agustinavelino/dash-40yd/docs/DASH_Documento_Maestro_v2.3.docx

# DASH TIMING SYSTEM

Sistema de cronometraje electrónico para dash de 40 yardas

DOCUMENTO MAESTRO DE ARQUITECTURA

Versión 2.3 · Reemplaza toda la documentación anterior

Campo | Detalle
Proyecto | DASH Timing System (nombre interno: Yellow-Dhaka)
Versión del documento | 2.3 — incorpora las corridas largas del VL53L1X en régimen sin retorno (fondo de vidrio, 24-oct-2026; cielo abierto, 26-oct-2026) y el ADR-013 (módulo ESP32 soldado y placa ensamblada por el fabricante). Sustituye v2.2, v2.1, v2.0, v1.0 y documentos de arquitectura previos.
Fecha de revisión | 26 de octubre de 2026
Tipo | Documento maestro de arquitectura, requisitos y plan de validación
Equipo | 1 desarrollador (servicio social / proyecto de portafolio)
Estado | Diseño congelado. Experimentos 0 y 0b completados; cadencia del sensor caracterizada (incluido el régimen sin retorno); esquemático de la PCB en curso. Pendiente compra de BOM.
Configuración | 4 puertas fijas (0 / 10 / 20 / 40 yd), reposicionables
Presupuesto estimado | $3,795 MXN (componentes + fabricación + logística). El costo de la placa ensamblada (ADR-013) está pendiente de cotización.

# 0. Sobre este documento

Este documento es la única fuente de verdad del proyecto DASH Timing System. Reemplaza en su totalidad a los siguientes documentos, que quedan marcados como obsoletos y deben archivarse en docs/history/ sin borrarse:

- dash_arquitectura_1.docx — SUPERSEDED
- dash_techstack.docx — SUPERSEDED
- DASH_Investigacion_Plan_Implementacion.docx (v1.0) — SUPERSEDED
- DASH_Documento_Maestro_v2.docx (v2.0), DASH_Documento_Maestro_v2.1.docx (v2.1) y DASH_Documento_Maestro_v2.2.docx (v2.2) — SUPERSEDED por esta versión 2.3

Esos documentos se conservan porque contienen el registro de decisiones que fueron evaluadas y descartadas. Ese historial es evidencia de criterio de ingeniería y es material valioso para el portafolio; lo que no debe ocurrir es que se sigan usando como especificación activa.

## 0.1 Qué cambió respecto a las versiones anteriores

Tema | Versión anterior | Versión 2.0
Puertas de medición | 3 puertas + receptor separado; split móvil | 4 puertas fijas (0/10/20/40 yd); la meta actúa como hub
Origen del timestamp | Central: el receptor marca la hora de llegada | Distribuido: cada nodo marca su propia hora + resync periódico
Puerta de inicio | No especificada | Disparo por levantamiento de mano (estándar NFL Combine)
Altura de montaje | No especificada | Altura de cadera (~1.0 m), inclinado 15–25° hacia arriba
Interfaz de usuario | App de escritorio Windows (Tkinter) | Página web servida por el propio ESP32 en modo SoftAP
Servidor en campo | Orange Pi Zero 2W / laptop | Ninguno. Cero infraestructura.
Nube | Fuera de alcance | Capa opcional de análisis e histórico (store & forward)
Identificación de atleta | RFID (v1.0: descartado) | Selección manual desde la página web
Requisito de precisión | ≤ 0.1 s (sin justificación) | Repetibilidad ≤ 0.05 s (1σ), con presupuesto de error por subsistema

## 0.2 Qué cambió en la versión 2.1

La versión 2.1 incorpora los resultados del smoke test y del barrido de configuración ejecutados el 11 de octubre de 2026 sobre un módulo TOF400C-VL53L1X en protoboard con un ESP32-WROOM-32U. Los números que antes venían de la hoja de datos ahora están medidos, y en un caso se corrige un concepto que estaba mal entendido (sección 9.2).

Estado de la evidencia. No todo tiene el mismo respaldo. Se marca explícitamente porque el principio rector del documento exige que cada decisión tenga un número o un criterio de prueba detrás:

Hallazgo | Respaldo | Firmeza
El periodo de INT es IMP × 0.931 | 3 puntos independientes, cociente idéntico a 4 cifras | Firme
Dos regímenes: 18.6 ms sin blanco, 37.24 ms con blanco | ~1450 muestras en dos corridas | Firme
Jitter de cadencia del chip = 10.6 µs | 51 muestras limpias, sin rescates intermedios | Firme
Alcance útil en modo corto ≈ 1.38 m | 4 transiciones observadas, consistentes | Firme
Asimetría entre regímenes: 13.7 % de intervalos anómalos sin retorno, 0 % con retorno | 648 muestras del smoke test, separadas por régimen, a IMP = 20 ms | Firme a IMP = 20 ms; sin caracterizar a 25 ms
IMP = 25 ms como configuración elegida | 51 muestras, cero saltos, todas con blanco válido | Provisional
I2C a 100 kHz; 400 kHz no aguanta | 1 observación en protoboard | Provisional

Los dos hallazgos provisionales llevan una nota explícita en el texto correspondiente. El de IMP necesita una corrida larga, apuntando al cielo con cruces intermitentes, para confirmar que el margen de 3.3 ms no se agota y que el régimen sin retorno se comporta bien a IMP = 25 ms. El de I2C se midió en protoboard con jumpers largos; sobre la PCB, con trazas cortas y pull-ups controlados, 400 kHz probablemente sí funcione y habrá que volver a medirlo.

Cambios por sección:

Sección | Cambio
1.1 | Estado actual: Experimento 0 aprobado y smoke test del sensor completado.
6 | Cuantización del muestreo recalculada con la ranura real medida: ±6.7 ms como piso, ~7.5 ms esperado con la asimetría entre regímenes (antes ±10 ms supuestos sobre una ventana de 20 ms).
9.2 | Reescrita. El timing budget y el inter-measurement period (IMP) son parámetros distintos; el techo temporal real es de 23.28 ms y sí es negociable. Asimetría entre régimen válido e inválido y su efecto sobre la cuantización.
9.3 | Alcance útil medido de 1.38 m; comportamiento ante fondo lejano y fondo traslúcido; muestras por cruce recalculadas con la ranura real.
9.4 | Comportamiento eléctrico del pin INT: activo en bajo y latcheado. Reglas obligatorias para registrar la ISR.
9.5 | Corrección de media ventana de 11.6 ms (antes 10 ms); interpolación del flanco marcada como no verificada; lockout expresado en ranuras de medición.
12.1, 12.2 | XSHUT pasa a ser obligatorio y se agrega a los test points; secuencia de reset por hardware; I2C a 100 kHz (provisional).
16.2 | Predicción del Experimento 1: 9.5 ms con ventanas uniformes, 10.7 ms con la tasa de intervalos anómalos medida; condiciones de montaje; emparejamiento de eventos por proximidad temporal.
18 | Nuevo ADR-011: inter-measurement period de 25 ms.
19 | Tres pasos nuevos antes del Experimento 1; la corrida larga de IMP se hace apuntando al cielo, no con blanco fijo.

Qué no cambia: ninguna decisión de arquitectura. El timestamp distribuido, el modo corto, el montaje a altura de cadera, la interrupción por hardware y el disparo por levantamiento de mano siguen igual de bien justificados que antes.

## 0.3 Qué cambió en la versión 2.2

La versión 2.2 incorpora dos mediciones: el barrido de configuración del VL53L1X en arranque en frío (barrido v5, 23-oct-2026) y el Experimento 0b, que midió la sincronización con el hub sirviendo la página web a varios teléfonos (23 y 24-oct-2026). Los reportes completos están en experimentos/sensor_vl53l1x/sensor_vl53l1x_resultados.md y experimentos/exp0b/experimento0b_resultados.md.

Estado de la evidencia. La tabla de 0.2 se conserva como registro de la versión 2.1. Lo nuevo, con su firmeza:

Hallazgo | Respaldo | Firmeza
Jitter de cadencia del chip: 48–315 µs según la corrida (el 10.6 µs de v2.1 no se reprodujo) | Barrido v5: 48–266 µs entre configuraciones (235 µs a IMP 25) y 44–315 µs en la misma configuración entre arranques | Varía entre corridas; siempre ≤ 1.4 % de la ranura
IMP = 25 ms entrega 1 ranura (23.31 ms) también en arranque en frío | Barrido v5: 119 intervalos, 0 anómalos; periodo = ⌈T / ranura⌉ × ranura en 11 configuraciones (desviación ≤ 0.009 ranuras) | Firme en régimen válido; régimen inválido pendiente
Margen real a IMP = 25 ms: 0.94–2.8 ms, no 3.3 ms | Barrido v5 acota la duración real de la medición a 20.48 < T ≤ 22.34 ms | Firme
Sincronización con el hub sirviendo la página: σ ≤ 488 µs | Experimento 0b: 6 corridas de 200 pulsos, 0 eventos perdidos | Firme
La carga del SoftAP sube las ráfagas de resync lentas de 14 % a 30 % | 100 ráfagas por condición; Fisher p = 0.010 | Firme en banco; sin medir en campo
Brownout del hub con SoftAP cargado y alimentación USB | 1 episodio de 422 reinicios y 1 reinicio aislado al abrir el puerto | Provisional: causa física sin aislar

Cambios por sección:

Sección | Cambio
1.1 | Estado actual: barrido del sensor en arranque en frío completado y Experimento 0b ejecutado.
6 | Sincronización entre nodos: se agrega el valor medido con el hub sirviendo la página (σ ≤ 0.49 ms por corrida).
9.2 | Margen de 0.94–2.8 ms en lugar de 3.3 ms; jitter de cadencia variable entre corridas; modelo de ranuras enteras; ADR-011 confirmado en arranque en frío.
11.2 | Evidencia de brownout del hub bajo carga del SoftAP.
13.2 | El aislamiento de núcleos deja de ser necesario para cumplir REQ-NF-02 y pasa a opción.
16.2 | Nueva: Experimento 0b. Los Experimentos 1–4 pasan a 16.3–16.6.
16.3 | Evidencia previa del Experimento 1 actualizada con el jitter de cadencia del barrido v5.
17 | Dos riesgos nuevos: brownout del hub y degradación del resync por la carga del SoftAP.
18 | ADR-011 con el margen real; ADR candidato de reintento de ráfagas lentas, pendiente de decisión.
19 | Pasos completados resumidos; pasos nuevos: decisión sobre el reintento de ráfagas y medición del riel de 3.3 V del hub.

Qué no cambia: ninguna decisión de arquitectura. El Experimento 0b confirma que el nodo de 40 yd puede ser meta y hub a la vez (ADR-002, ADR-009): no hace falta un quinto ESP32 dedicado al SoftAP.

## 0.4 Qué cambió en la versión 2.3

La versión 2.3 incorpora dos corridas largas del VL53L1X a IMP = 25 ms en régimen sin retorno, con cruces guiados por un LED: fondo de vidrio fuera de alcance (24-oct-2026) y cielo abierto (26-oct-2026). Además registra el ADR-013, que cambia la placa de producto. El reporte del sensor está en experimentos/sensor_vl53l1x/sensor_vl53l1x_resultados.md (secciones 11 y 12) y el ADR en docs/adr/ADR-013-modulo-soldado-pcba.md.

Estado de la evidencia. Las tablas de 0.2 y 0.3 se conservan como registro. Lo nuevo, con su firmeza:

Hallazgo | Respaldo | Firmeza
IMP = 25 ms no salta a 2 ranuras (46.6 ms) con blanco | 0 de 2 076 intervalos con blanco en dos corridas largas (vidrio 0/1 054, cielo 0/1 022) | Firme
Sin blanco, 3.0–3.3 % de intervalos anómalos a IMP = 25 ms (13.7 % a IMP = 20 ms) | 3 918 intervalos al cielo y 3 878 con vidrio; fondo verificado: 0 y 1 muestras válidas con el LED apagado hace más de 1 s | Firme
Dos fases del INT: sin blanco va ~9.5–9.9 ms adelantado; la primera detección de cada cruce cae en la fase con blanco | 29 de 29 cruces al cielo y 30 de 31 con vidrio; los anómalos sin blanco son una sola interrupción tardía (51 de 60 pares + −) | Firme como observación; el mecanismo (medición abortada sin retorno) no está verificado
Efecto del cambio de fase en el error del cruce | Escenario: si la ventana de la detección es el intervalo completo (~33.2 ms), σ ≈ 9.6 ms por sensor | Sin medir: lo mide el Experimento 1
Módulo ESP32 soldado y placa ensamblada por el fabricante (ADR-013) | Decisión de diseño; resuelve las dos fuentes en el riel de 3.3 V y los footprints de módulos genéricos | Decisión; costo pendiente de cotización

Cambios por sección:

Sección | Cambio
Portada y 0 | Versión 2.3 y esta sección.
1.1 | Estado actual: cadencia del sensor caracterizada, esquemático de la PCB en curso (ADR-013), prototipo de la página web.
9.2 | Corridas largas a IMP = 25 ms en régimen sin retorno; la nota provisional se cierra; hallazgo de las dos fases del INT.
9.3 | El cielo abierto se confirma como fondo sin retorno.
9.5 | La corrección de media ventana queda sujeta al cambio de fase en el cruce.
12.1, 12.2, 12.5 | ADR-013: módulo WROOM-32UE soldado, cargador y buck-boost con integrados, un solo USB-C con CH340C, ensamblado por el fabricante.
15.1, 15.2 | Notas del ADR-013; el costo de fabricación con ensamblado queda pendiente de cotización.
16.3 | El Experimento 1 debe registrar el intervalo previo a cada detección. La predicción escrita no cambia.
17 | Riesgos de la PCB y de los módulos genéricos actualizados por el ADR-013.
18 | ADR-011 confirmado en régimen sin retorno; ADR-013 nuevo.
19 | Corrida larga del sensor completada; pasos nuevos: cotización de la placa ensamblada y embeber la página.

Qué no cambia: IMP = 25 ms (ADR-011) se mantiene, y ninguna decisión de arquitectura de tiempo, comunicación o software cambia. El ADR-013 cambia solo la placa de producto: los experimentos siguen sobre tarjetas de desarrollo.

Principio rector del documento

Toda decisión técnica aquí registrada tiene una justificación numérica o un criterio de prueba asociado. Si una decisión no puede defenderse con un número o con un experimento, es una preferencia, no una decisión de ingeniería, y debe marcarse como tal.

# 1. Resumen ejecutivo

DASH Timing System es un sistema portátil de cronometraje electrónico de bajo costo para medir el dash de 40 yardas y sus tiempos de split intermedios, dirigido a una liga juvenil de futbol americano en la Ciudad de México.

El sistema está compuesto por cuatro dispositivos físicos idénticos, construidos sobre un único diseño de PCB, cuyo rol se define por configuración mediante jumpers. Cada dispositivo integra una tarjeta ESP32-WROOM-32UE con antena externa, un sensor de distancia por Tiempo de Vuelo (ToF) VL53L1X y un subsistema de energía basado en celda Li-ion 18650.

Los cuatro dispositivos se colocan a lo largo de un carril lineal en las marcas de 0, 10, 20 y 40 yardas, replicando el protocolo del NFL Combine. Cada nodo detecta el cruce del atleta mediante interrupción por hardware del sensor y marca el instante con su propio reloj local. Los relojes se mantienen alineados mediante un protocolo de resincronización periódica por ESP-NOW, de modo que la latencia variable del enlace inalámbrico no contamina la medición.

El nodo de meta cumple además el rol de concentrador: agrega los timestamps de las cuatro puertas, calcula los splits y levanta un punto de acceso WiFi propio (SoftAP) que sirve una página web ligera. El coach se conecta desde su teléfono y ve los resultados en menos de dos segundos, sin necesidad de laptop, router, internet ni ningún equipo adicional en el campo.

De forma opcional y no crítica, cuando exista conectividad a internet el sistema sincroniza el histórico hacia un backend en la nube donde reside el análisis pesado: perfiles de velocidad, comparativas entre atletas, progreso longitudinal y ajuste del modelo biomecánico de sprint.

## 1.1 Estado actual

Elemento | Estado
Arquitectura y requisitos | Congelados en este documento
Componentes | Kit de arranque en uso (ESP32-WROOM-32U en protoboard, módulo TOF400C-VL53L1X). Resto del BOM pendiente de compra.
Validación de sincronización inalámbrica | Completada — Experimento 0 aprobado: σ = 168 µs, margen de 30× sobre REQ-NF-02. Experimento 0b (hub con SoftAP y carga web): σ ≤ 488 µs, margen de 10× (sección 16.2).
Caracterización del sensor ToF | Cadencia completada — smoke test y barridos (11 y 23-oct-2026) y corridas largas en régimen sin retorno con vidrio y al cielo abierto (24 y 26-oct-2026), sección 9.2. Pendientes: Experimento 1 y pruebas solares.
Diseño de PCB | Esquemático en curso: módulo WROOM-32UE soldado y placa ensamblada por el fabricante (ADR-013), con las adiciones de la sección 12.
Firmware | Firmware de experimentos sobre protoboard (Experimentos 0 y 0b, smoke test y barridos del sensor). Firmware de producto no iniciado.
Página web local | Prototipo hecho con hub simulado (24-oct-2026), 8.7 KB con gzip, contrato hub ↔ página en webapp/PROTOCOLO.md. Falta embeberla en el hub. El Experimento 0b confirmó que el hub puede servir una página de 237 KB comprimida a 3 teléfonos sin salir de REQ-NF-02.
Backend en nube | No iniciado — fase posterior, no bloqueante

# 2. Planteamiento del problema

Los programas de futbol americano juvenil miden el dash de 40 yardas con cronómetros manuales operados por entrenadores, quienes además aproximan los splits intermedios a ojo. Esta práctica introduce tres problemas medibles:

- Error de reacción humana: el operador arranca y detiene el cronómetro con un retardo de reacción de 150–300 ms, sesgado sistemáticamente hacia tiempos más rápidos.
- Falta de repetibilidad: dos operadores distintos, o el mismo operador en dos ocasiones, producen tiempos que difieren lo suficiente como para enmascarar el progreso real del atleta.
- Ausencia de splits confiables: sin tiempos intermedios no es posible distinguir un atleta con buena aceleración de uno con buena velocidad máxima, que es precisamente la información que cambia el plan de entrenamiento.

DASH resuelve esto con un sistema electrónico portátil que mide automáticamente el tiempo total y los splits, con repetibilidad de nivel entrenamiento, instalable y operable en minutos por usuarios sin conocimientos técnicos, en condiciones reales de campo.

Advertencia operativa que debe comunicarse al coach antes de la primera sesión

Los tiempos cronometrados a mano son sistemáticamente más rápidos que los electrónicos, típicamente por 0.20–0.30 s, debido al retardo de reacción del operador. Los tiempos de los atletas parecerán empeorar el día que se instale el sistema. Si esta conversación no se tiene por adelantado, el sistema será percibido como descalibrado. Documentar el sesgo y explicarlo es parte del entregable, no un detalle accesorio.

# 3. Objetivos

- Medir el dash de 40 yardas con splits en 10 y 20 yardas, replicando el protocolo del NFL Combine, en una sola corrida del atleta.
- Alcanzar repetibilidad de 0.05 s (1σ) o mejor en corridas repetidas del mismo atleta bajo condiciones equivalentes.
- Entregar retroalimentación visible al coach y al atleta en menos de 2 segundos tras cruzar la meta, sin requerir laptop, router, internet ni infraestructura de red en el campo.
- Permitir instalación y puesta en marcha completa en 10 minutos o menos por un usuario sin conocimientos técnicos.
- Operar de forma confiable a la intemperie bajo condiciones típicas de la Ciudad de México, incluyendo sol directo y lluvia ligera.
- Mantener una plataforma de hardware estandarizada: un único diseño de PCB replicado en los cuatro dispositivos, con el rol definido por configuración.
- Garantizar cero pérdida de datos ante fallas de conectividad, mediante almacenamiento local y sincronización diferida.
- Habilitar análisis de desempeño más allá de los tiempos crudos: velocidades por tramo, curva de aceleración y ajuste del modelo biomecánico de sprint.
- Garantizar reproducibilidad total del proyecto: diseño de PCB, firmware, software, documentación de ensamble y procedimientos de calibración publicados.
- Demostrar competencia de ingeniería de nivel profesional en firmware embebido, sistemas inalámbricos de sensado, diseño de PCB, integración hardware-software y validación experimental.

# 4. Alcance y no-objetivos

La Versión 1 comprende un sistema de cronometraje de carril único para medir desempeño en línea recta. Cuatro estaciones sensoras se colocan a lo largo de una pista lineal, se comunican de forma local e inalámbrica, y presentan resultados en una página web servida por el propio sistema.

El diseño contempla operación en interiores y exteriores, con las estaciones montadas en tripié sobre terreno razonablemente nivelado, tolerando exposición solar y lluvia ligera. Toda la comunicación ocurre en una red inalámbrica local; la conectividad a internet es estrictamente opcional y nunca está en la ruta de medición.

## 4.1 No-objetivos explícitos

- Cronometraje multi-carril o de múltiples atletas simultáneos.
- Identificación automática del atleta (RFID, NFC, visión). La selección es manual desde la interfaz web.
- Aplicación móvil nativa. La interfaz es una página web abierta en el navegador del teléfono.
- Aplicación de escritorio. Eliminada respecto a v1.0.
- Dependencia de conectividad a internet para la operación de medición.
- Analítica basada en IA o interpretación automática del desempeño.
- Precisión certificada de competencia profesional.

# 5. Requisitos y criterios de éxito

Los requisitos de la versión 1.0 se revisan aquí. En particular, el requisito anterior de precisión (≤ 0.1 s) se reemplaza porque era demasiado laxo: el sistema lo cumple sin esfuerzo de diseño, y un requisito que se satisface solo no sirve para guiar decisiones ni para detectar regresiones.

## 5.1 Requisitos funcionales

ID | Requisito | Criterio de prueba
REQ-F-01 | Detectar el cruce del atleta en las cuatro puertas | Pruebas controladas de caminata y carrera activan las 4 puertas en el orden esperado
REQ-F-02 | Iniciar el cronometraje por levantamiento de mano en modo armado | El cronómetro arranca sin intervención humana al despejarse la puerta de inicio
REQ-F-03 | Registrar splits de 10, 20 y 40 yardas en una sola corrida | Los tiempos registrados corresponden a la secuencia esperada y son monótonos crecientes
REQ-F-04 | Asociar cada corrida con un atleta del roster | El coach selecciona el atleta en la página web y el CSV refleja la asociación
REQ-F-05 | Mostrar resultados en el teléfono del coach | Resultados visibles en ≤ 2 s tras el cruce de meta
REQ-F-06 | Registrar la distancia real de cada puerta con cada corrida | El CSV incluye las distancias configuradas; al mover una puerta y actualizar el parámetro, el cambio se refleja
REQ-F-07 | Exportar los datos a CSV | Archivo descargable desde la página web y legible en hoja de cálculo
REQ-F-08 | Permitir promover cualquier nodo al rol de hub | Cambiando los jumpers, un nodo sensor asume el rol de concentrador y el sistema opera en modo degradado

## 5.2 Requisitos no funcionales

ID | Requisito | Criterio de prueba
REQ-NF-01 | Repetibilidad de medición ≤ 0.05 s (1σ) | Análisis estadístico de 10 corridas repetidas del mismo atleta
REQ-NF-02 | Jitter de la infraestructura de tiempo ≤ 5 ms (1σ) | Experimento 0: histograma de 200 disparos con evento común cableado
REQ-NF-03 | Tasa de detección ≥ 99 % con el atleta dentro del carril marcado | 200 pasadas; se contabilizan las no detectadas
REQ-NF-04 | Instalación completa en ≤ 10 minutos | Un usuario nuevo completa el despliegue cronometrado
REQ-NF-05 | Autonomía mínima de 1 hora continua en modo armado | Prueba de descarga bajo ciclo de trabajo real de sensado y radio
REQ-NF-06 | Operación bajo sol directo y lluvia ligera | Operación exitosa en campo a mediodía y bajo aspersión controlada
REQ-NF-07 | Cero pérdida de datos ante caída de conectividad | Se desconecta la red durante una sesión; al restablecerse, todos los resultados están presentes
REQ-NF-08 | La página web opera sin acceso a internet | El teléfono conectado al SoftAP, sin datos móviles, carga la página completa

# 6. Presupuesto de error

Esta sección es la base cuantitativa de todas las decisiones de diseño del documento. Ninguna elección de componente o arquitectura debe tomarse sin referirse a ella.

El error total del sistema se descompone en contribuciones independientes que se combinan en raíz de la suma de cuadrados (RSS), porque son fuentes aleatorias no correlacionadas entre sí.

Fuente de error | Magnitud (1σ) | Naturaleza y tratamiento
Geometría corporal | ±20–50 ms | DOMINANTE. Qué parte del cuerpo cruza primero varía con la fase de zancada. Se mitiga con altura de montaje, no se elimina.
Cuantización del muestreo | ±6.7 ms (MEDIDO) | Ranura real de 23.28 ms (IMP 25 ms). σ = ventana / √12 = 6.72 ms. Dentro del presupuesto de ±10 ms. Valor de piso: supone ventanas uniformes. Con la tasa de intervalos anómalos medida en régimen inválido, el valor esperado sube a ~7.5 ms (sección 9.2).
Sincronización entre nodos | ±0.17 ms (MEDIDO); ≤ 0.49 ms con carga web (MEDIDO) | Resync ping-pong cada 30 s con filtro de latencia mínima sobre ráfaga de 7. Verificado por el Experimento 0: σ = 168 µs, 30× mejor que REQ-NF-02. Con el hub sirviendo la página a 3 teléfonos (Experimento 0b, 16.2): σ ≤ 488 µs por corrida, error del offset σ 217 µs y máximo 935 µs sobre 100 ráfagas; 10× mejor que REQ-NF-02.
Deriva de cristal | ±1 ms | 35 ppm relativos entre dos cristales = 35 µs/s. Con resync a 30 s no alcanza a acumularse.
Latencia de ISR y firmware | < 0.1 ms | Despreciable si el timestamp se captura como primera instrucción de la ISR.
Latencia del enlace de radio | 0 ms | ELIMINADA por diseño: el timestamp nace en el nodo, no en el receptor.

Error total por puerta: la contribución de sincronización resultó un orden de magnitud menor que lo presupuestado, por lo que el error total queda aún más dominado por la geometría corporal de lo que se estimaba originalmente. Esto refuerza la conclusión de 6.1: invertir en resolución temporal no produce mejora significativa.

La cuantización del sensor se determinó a partir del periodo real de muestreo medido (sección 9.2) y resultó de 6.7 ms (1σ), dentro del presupuesto estimado. Sumada en cuadratura con la geometría corporal, el error total por puerta queda prácticamente sin cambio respecto a la estimación original, porque la geometría sigue dominando por un factor de 3 a 7.

## 6.1 Consecuencias de diseño

- El sistema distingue confiablemente un 5.10 de un 5.20. No distingue un 5.10 de un 5.12. Los tiempos se reportan a centésimas, acompañados de la incertidumbre documentada.
- La geometría corporal domina el presupuesto. Por lo tanto, invertir en un sensor con mayor resolución temporal produciría una mejora marginal (del orden del 5 %) a costo y complejidad significativos. El VL53L1X es la elección correcta precisamente porque su error es del mismo orden que el error irreducible.
- Un enlace cableado eliminaría el error de sincronización (~1–2 ms), lo que representa aproximadamente el 3 % del error total, a cambio de tender 80 m de cable en un campo donde hay atletas esprintando. La relación costo-beneficio es desfavorable y viola REQ-NF-04. Ver ADR-007.
- Buena parte del error de geometría corporal es sistemático para un mismo atleta en un mismo día, por lo que las comparaciones relativas (progreso, ranking) son más confiables que los valores absolutos. Este es el uso principal que le dará el coach.

# 7. Arquitectura del sistema

## 7.1 Topología física

Cuatro dispositivos idénticos, montados en tripié al costado del carril de carrera, en las marcas de 0, 10, 20 y 40 yardas. La configuración por defecto replica el protocolo del NFL Combine, pero al ser inalámbricos los nodos pueden reposicionarse libremente; la distancia real de cada puerta es un parámetro configurable en la interfaz (REQ-F-06).

Puerta | Rol de firmware | Función
0 yd | Nodo de inicio | Sensor apuntando hacia abajo a la mano de apoyo del atleta. Dispara por flanco de subida (la mano se levanta).
10 yd | Nodo de split | Sensor apuntando al carril. Dispara por flanco de bajada (cuerpo entra al haz).
20 yd | Nodo de split | Idéntico al de 10 yd.
40 yd | Nodo de meta + hub | Detecta la meta, agrega los timestamps de las cuatro puertas, calcula splits, levanta SoftAP y sirve la página web.

## 7.2 Flujo de una corrida

1. El coach abre la página web del sistema desde su teléfono, selecciona al atleta y arma el sistema.
2. El atleta se coloca en posición de tres puntos, con la mano de apoyo bajo el sensor de la puerta de 0 yd.
3. El atleta arranca. Al levantar la mano, el nodo de inicio detecta el flanco de subida y captura T0 con su reloj local.
4. El atleta cruza 10, 20 y 40 yardas. Cada nodo captura su timestamp local mediante interrupción por hardware.
5. Cada nodo transmite su evento al hub por ESP-NOW. El instante de llegada del paquete es irrelevante para la medición.
6. El hub aplica los offsets de reloj conocidos, calcula los splits y el tiempo total, y almacena el resultado localmente.
7. La página web del coach se actualiza y muestra el resultado en menos de 2 segundos.
8. Si hay conectividad a internet disponible, el hub sincroniza el resultado al backend en la nube. Si no la hay, el dato permanece en el buffer local hasta que la haya.

## 7.3 Interfaces entre subsistemas

Interfaz | Tipo | Datos / Señal | Responsable
Sensor → MCU (datos) | I2C | Valor de distancia | Nodo sensor
Sensor → MCU (evento) | GPIO / interrupción | Flanco de detección | Hardware + firmware
Nodo → Hub | ESP-NOW | Paquete con timestamp local y traza de muestras | Firmware
Hub ↔ Nodos | ESP-NOW | Protocolo de resincronización de reloj | Firmware
Hub → Coach | WiFi SoftAP / HTTP | Página web y resultados en vivo | Firmware + web
Hub → Nube | WiFi cliente / HTTPS | Sincronización diferida de histórico | Firmware + backend
Energía → Nodo | 3.3 V DC | Riel regulado | Subsistema de energía

# 8. Geometría de montaje y semántica de disparo

## 8.1 Altura de montaje

Un sensor de puerta no detecta un atleta: detecta el primer objeto sólido que entra en su haz. El cuerpo de un corredor no cruza la línea como un bloque; las extremidades se despliegan por delante del torso y oscilan según la fase de zancada.

Punto del cuerpo | Adelanto típico | Consecuencia
Mano en swing | ~45 cm | Adelanta el disparo ~50 ms y varía corrida a corrida
Pie en extensión | ~50 cm | Adelanta el disparo ~55 ms y varía con la cadencia
Cadera | referencia | Punto de mínima varianza; proxy del centro de masa

Decisión: montar el plano de detección a la altura de la cadera del atleta, en el rango de 0.9 a 1.1 m según el roster real. La cadera se mueve a velocidad casi constante mientras las extremidades oscilan alrededor de ella, por lo que es el punto que minimiza la varianza entre corridas.

Una vez fijada, la altura de montaje se documenta como parámetro de calibración y no se modifica entre sesiones; cambiarla invalida las comparaciones históricas.

## 8.2 Inclinación del sensor

El sensor se monta bajo (aproximadamente 0.5–0.6 m) e inclinado 15–25° hacia arriba, apuntando a la altura de cadera del atleta. Esta geometría responde a dos razones independientes que apuntan en la misma dirección:

- Mecánica: el trípode queda con centro de gravedad bajo, es más estable frente al viento, y sus patas quedan más lejos de la trayectoria del atleta.
- Óptica: al apuntar hacia arriba, el fondo del haz es cielo abierto, es decir, ausencia de retorno. Esto convierte la detección en un evento binario limpio (sin retorno → retorno válido a ~1 m) en lugar de una detección diferencial contra un fondo variable como pasto, barda o público.

## 8.3 Semántica de disparo: por qué la puerta de inicio es distinta

Para las puertas de 10, 20 y 40 yardas la lógica es directa: se dispara por flanco de bajada, es decir, cuando la distancia medida cae abruptamente porque un cuerpo entró al haz.

La puerta de inicio no puede usar esa lógica. En un dash de 40 yardas el atleta arranca detenido, en posición de tres puntos, con la mano apoyada sobre la línea de salida. Si la puerta de inicio dispara por bloqueo, el cronómetro arranca cuando el atleta se acomoda, no cuando arranca.

Opción | Mecanismo | Evaluación
A — Atleta detrás | El atleta se coloca ~30 cm detrás de la línea; flanco de bajada normal | Hardware idéntico, pero el brazo al extenderse dispara antes que la cadera y la distancia de retraso varía por atleta
B — Flanco de subida | El atleta se acomoda dentro del haz; arranca al despejarlo | Auto-disparo, pero el despeje ocurre cuando sale la última parte del cuerpo, no cuando arrancó
C — Levantamiento de mano | Sensor apuntando hacia abajo a la mano de apoyo; dispara al levantarse | SELECCIONADA. Es el estándar del NFL Combine y el único evento discreto y bien definido

Se selecciona la opción C. El levantamiento de la mano es un evento binario y repetible, a diferencia de un cuerpo cruzando un plano, que es intrínsecamente borroso. Reduce el error de la puerta de inicio de aproximadamente ±50 ms a ±20 ms, y el inicio es donde el error duele más porque contamina todos los splits de la corrida. No implica hardware adicional: es el mismo módulo, el mismo sensor, apuntando hacia abajo, con lógica de flanco de subida en firmware.

# 9. Sensado por Tiempo de Vuelo

## 9.1 Principio de funcionamiento

El VL53L1X emite pulsos de láser infrarrojo a 940 nm, mide el tiempo de viaje de ida y vuelta de la luz reflejada, y calcula la distancia. Dado que la luz viaja a aproximadamente 30 cm por nanosegundo, la medición interna ocurre en el orden de picosegundos y la realiza silicio dedicado (arreglo de fotodiodos SPAD más convertidor tiempo-digital). El microcontrolador nunca participa en esa medición: solo lee el resultado.

## 9.2 Timing budget e inter-measurement period: el techo temporal

Un solo pulso produce una señal demasiado débil. El chip acumula fotones de miles de pulsos para promediar el ruido; ese periodo de acumulación es el timing budget. Más budget significa mediciones más limpias y de mayor alcance, pero más lentas.

El timing budget no es, sin embargo, la cadencia con la que el sensor avisa al microcontrolador. Esa la fija un segundo parámetro independiente, el inter-measurement period (IMP), y la relación entre ambos determina el techo real del sistema. Confundirlos fue un error de la versión anterior de este documento.

Medición (smoke test, 11-oct-2026, módulo TOF400C sobre protoboard):

periodo real de INT = IMP solicitado × 0.931

El factor 0.931 es un error de escala del 6.9 % que introduce la conversión de milisegundos a cuentas del oscilador interno del sensor. Se verificó con tres valores independientes de IMP (25, 33 y 40 ms), que arrojaron cocientes de 0.9313, 0.9309 y 0.9307.

La consecuencia práctica es que la ranura temporal real debe ser mayor que el budget; de lo contrario el chip no alcanza a terminar la medición dentro de ella y se salta una ranura completa:

IMP solicitado | Ranura real | ¿Cabe un budget de 20 ms? | Periodo de INT
20 ms | 18.62 ms | No | 37.24 ms (se salta una)
25 ms | 23.28 ms | Sí | 23.28 ms
33 ms | 30.72 ms | Sí | 30.72 ms
40 ms | 37.23 ms | Sí | 37.23 ms

Esto explica un comportamiento observado en el smoke test que parecía anómalo: con IMP = 20 ms el sensor entregaba 18.6 ms cuando no había blanco y 37.24 ms cuando sí lo había. Sin blanco la medición aborta temprano y cabe en la ranura; con blanco válido usa el budget completo, no cabe, y el chip entrega cada dos ranuras.

Configuración seleccionada: IMP = 25 ms, que produce un periodo real de 23.28 ms (43 mediciones por segundo). Es la ranura más corta que acomoda una medición completa en modo corto, con un margen de entre 0.94 y 2.8 ms (ver el barrido en arranque en frío, abajo). Ver ADR-011.

Estabilidad de la cadencia: en el smoke test el jitter medido fue de 10.6 µs (1σ) sobre 51 muestras. El barrido en arranque en frío no lo reprodujo: midió 48–266 µs según la configuración (235 µs a IMP = 25 ms) y 44–315 µs en una misma configuración entre arranques. Aun el máximo es ≤ 1.4 % de la ranura: el chip mantiene su ritmo con su propio reloj, lo que confirma que la cuantización de la ventana es la única fuente significativa de error temporal del sensor.

Barrido en arranque en frío (23-oct-2026): once valores de IMP entre 10 y 25 ms, un arranque en frío por configuración, blanco fijo a 1.105 m, 120 muestras cada uno. En todos el periodo resultó un número entero de ranuras, periodo = ⌈T / ranura⌉ × ranura, con desviación ≤ 0.009 ranuras. IMP = 25 ms dio 1 ranura (23.31 ms) con 0 de 119 intervalos anómalos: ADR-011 se confirma también en arranque en frío. Como IMP = 22 ms necesita 2 ranuras (20.48 ms no alcanzan) e IMP = 12 ms cabe en 2 × 11.17 = 22.34 ms, la duración real de la medición queda acotada a 20.48 < T ≤ 22.34 ms. El margen real a IMP = 25 ms está entre 0.94 y 2.8 ms, no los 3.3 ms que resultaban de suponer T igual al budget.

Asimetría entre regímenes. La estabilidad anterior corresponde al régimen con retorno válido. El análisis separado de las 648 muestras del smoke test muestra que los dos regímenes no se comportan igual:

Régimen | Intervalos anómalos | Jitter de los limpios
Válido (con blanco) | 0 de 404 (0 %) | 81 µs
Inválido (sin retorno) | 33 de 241 (13.7 %) | 266 µs

En el régimen inválido uno de cada siete intervalos se alarga aproximadamente 9.3 ms, medio cuanto de la cadencia interna. El régimen válido no presenta un solo caso.

Esto tiene consecuencia directa sobre el presupuesto de error, porque las puertas de split y meta apuntan al cielo y permanecen en régimen inválido hasta que llega el atleta. Si las ventanas de medición no son todas del mismo ancho, el error de cuantización deja de ser uniforme y su varianza aumenta. Estimado con la tasa medida:

| Sin intervalos anómalos | Con la tasa medida
σ de cuantización por sensor | 6.72 ms | 7.54 ms (+12 %)
Predicción del Experimento 1 | 9.5 ms | 10.7 ms

El presupuesto de ±10 ms se sostiene, pero 6.72 ms debe leerse como piso, no como valor esperado.

La puerta de inicio es la excepción: apunta hacia abajo a la mano y después al suelo, por lo que siempre tiene retorno válido y opera en el régimen limpio.

Esta tasa se midió a IMP = 20 ms. A IMP = 25 ms resultó mucho menor (3.0–3.3 %, abajo).

A 9 m/s el atleta recorre 21 cm entre muestras.

Corridas largas a IMP = 25 ms en régimen sin retorno (24 y 26-oct-2026). 5 000 interrupciones por corrida en arranque en frío, con cruces de mano o cartulina a 0.3–1 m guiados por un LED que se enciende 1 s cada 4 s. El estado del LED queda en cada muestra, lo que permite verificar que el fondo no da retorno:

Corrida | Sin blanco: intervalos anómalos | Con blanco: saltos a 2 ranuras
Smoke test, IMP = 20 ms (11-oct) | 33 de 241 (13.7 %), +9.3 ms | —
Vidrio a ~2 m, IMP = 25 ms (24-oct) | 127 de 3 878 (3.3 %), ±9.5 ms | 0 de 1 054
Cielo abierto, IMP = 25 ms (26-oct) | 118 de 3 918 (3.0 %), ±9.9 ms | 0 de 1 022

El fondo no cambia la cadencia: al cielo, 0 de 2 471 muestras salieron válidas con el LED apagado hace más de 1 s (vidrio: 1 de 2 473). El chip reporta el cielo sobre todo como status 2 (signal fail) y el vidrio como status 4 (fuera de rango); la cadencia es la misma.

Dos fases del INT. Midiendo la fase de cada interrupción contra sus vecinas: sin blanco, el INT va ~9.9 ms adelantado (9.5 ms con vidrio) respecto a la fase con blanco. En los 29 cruces al cielo, la primera muestra válida llega en la fase con blanco, +10.0 ms (mediana) respecto a las muestras anteriores; con vidrio, 30 de 31. Los anómalos sin blanco son casi todos una sola interrupción que regresa un instante a la fase con blanco (un intervalo largo seguido de uno corto: 51 de 60), casi siempre con status 2. Hipótesis sin verificar: sin retorno la medición aborta antes de completar el budget y el INT sale antes.

Consecuencia para el presupuesto de error. La tabla de arriba (7.54 ms, 10.7 ms) suponía que el intervalo largo era la excepción (13.7 %). A IMP = 25 ms los anómalos sin blanco son 3 %, pero el intervalo que termina en la detección es el largo (~23.3 + 9.9 ≈ 33.2 ms) en cada cruce. Si la ventana de cuantización de la detección fuera ese intervalo completo, σ ≈ 33.2 / √12 ≈ 9.6 ms por sensor, todavía dentro de ±10 ms pero sin margen. No está medido: depende de en qué momento de la medición el chip ve el blanco. Lo resuelve el Experimento 1 (sección 16.3).

Nota (cerrada el 26-oct-2026)

La elección de IMP = 25 ms se validó con 51 muestras sin saltos, se confirmó en arranque en frío (119 intervalos, 0 anómalos) y después en régimen sin retorno con dos corridas largas, contra un vidrio y al cielo abierto. Las dos dudas de la versión 2.2 quedan resueltas:

1. El margen de 0.94–2.8 ms no se agotó: 0 saltos a 46.6 ms en 2 076 intervalos con blanco.

2. El régimen inválido a IMP = 25 ms se comporta mejor que a IMP = 20 ms: 3.0–3.3 % de intervalos anómalos contra 13.7 %, sin perder ranuras.

Los valores de IMP entre 26 y 28 ms ya no hacen falta como alternativa. Queda una pregunta nueva, que no cuestiona el IMP: cuánto error agrega el cambio de fase de ~9.9 ms en el instante del cruce. La responde el Experimento 1.

## 9.3 Modo de corta distancia

Se opera el sensor en modo de corta distancia (alcance nominal ~1.3 m). Esta decisión responde a dos motivaciones que coinciden:

- Inmunidad a luz ambiente: el sol emite fuertemente en 940 nm, la misma longitud de onda del sensor. Bajo sol directo el alcance útil se desploma. El modo corto es el más robusto frente a esta interferencia.
- Resolución temporal: el modo corto permite el timing budget más bajo, que es exactamente lo que se necesita para cronometrar.

Alcance útil medido: 1.38 m (smoke test, 11-oct-2026). El corte es abrupto y repetible: en cuatro transiciones observadas el estatus pasó de válido a fuera de rango entre 1372 y 1395 mm. Este valor, y no el nominal de hoja de datos, es el que debe usarse para fijar el ancho del carril marcado con conos.

Se observó también que un fondo lejano en modo corto se comporta como ausencia de retorno, lo que confirma la premisa de la sección 8.2. El tipo de fondo importa: una superficie traslúcida (cortina sheer a 2.3 m) produjo una mezcla inestable de estatus inválidos, porque parte de la luz la atraviesa y genera dos retornos a distancias distintas. En campo el fondo es cielo abierto, que es el mejor caso posible. Confirmado el 26-oct-2026: al cielo abierto, 0 de 2 471 muestras válidas sin blanco (sección 9.2).

Restricción operativa derivada: el atleta debe pasar a menos de 1.3 m del trípode. Se mitiga marcando el carril con conos. Los modos medio (3 m) y largo (4 m) quedan como alternativa a caracterizar en campo: si en condiciones de entrenamiento vespertino resultan confiables, otorgan margen adicional. Esta caracterización es parte del plan de validación (sección 16).

Nota sobre el campo de visión: a 27° y 80 cm el haz mide aproximadamente 38 cm. A 9 m/s el atleta recorre 21 cm entre muestras (sección 9.2), de modo que un punto del cuerpo cruzando el haz produce cerca de 2 muestras, y el torso completo, considerando su extensión longitudinal, alrededor de 3. En las puertas de 10 y 20 yardas el atleta va más lento y el número es mayor. Reducir el ROI para ganar inmunidad adicional dejaría 1 muestra y eliminaría la capacidad de validar el evento. No se debe optimizar el ROI antes de haber medido.

## 9.4 Detección por interrupción de hardware

El método por el cual el microcontrolador se entera de un evento determina directamente el jitter de la medición. Hay dos opciones y sólo una es aceptable.

Método | Mecanismo | Evaluación
Polling | El MCU consulta por I2C repetidamente si hay dato nuevo | Cada consulta ocupa el bus ~0.5 ms; el instante real del evento queda indeterminado dentro del ciclo de polling. Introduce decenas de ms de jitter.
Interrupción | El sensor baja físicamente el pin INT cuando se cumple la condición; el MCU salta a la ISR en ~2 µs | SELECCIONADA. El timestamp se captura antes de tocar el bus I2C.

La interrupción requiere las tres cosas simultáneamente:

- Hardware: una conexión física del pin INT del módulo sensor a un GPIO del ESP32. Sin este cable la interrupción no existe.
- Configuración del sensor por I2C: se programa el chip para que active INT únicamente cuando la distancia medida cruza un umbral definido. De este modo la detección del atleta ocurre en hardware, dentro del sensor.
- Configuración del firmware: se registra la rutina de servicio de interrupción sobre el GPIO correspondiente.

El VL53L1X dispone de un detector de umbral en hardware con modos de ventana configurables. La dirección del cruce que genera la interrupción difiere según el rol del nodo:

- Puerta de inicio (0 yd): modo «por encima del umbral». El sensor apunta hacia abajo a la mano de apoyo, a aproximadamente 10 cm. INT se activa cuando la distancia supera el umbral, es decir, cuando la mano se levanta y el sensor pasa a ver el suelo. Corresponde a la semántica de la sección 8.3, opción C.
- Puertas de split y meta (10/20/40 yd): modo «por debajo del umbral». INT se activa cuando la distancia cae por debajo del umbral, es decir, cuando un cuerpo entra al haz.

Ambos roles comparten hardware, PCB y binario de firmware. La diferencia se reduce a los registros de configuración escritos al arrancar, seleccionados por el jumper de rol (ADR-009).

La rutina de servicio de interrupción captura el tiempo como su primera instrucción y sale de inmediato. La lectura del valor de distancia, el procesamiento y la transmisión ocurren después, fuera de la ruta crítica.

Comportamiento eléctrico del pin INT (verificado en banco). El pin es activo en BAJO y queda LATCHEADO: permanece abajo hasta que el firmware limpia la interrupción leyendo los resultados por I2C. De ahí se derivan dos reglas de firmware que no son opcionales:

- La ISR se registra por flanco de bajada, no de subida.
- La ISR debe registrarse después de arrancar el modo continuo y con el pin ya limpio. Si se registra mientras el pin está abajo, no habrá flanco que detectar, la ISR no disparará, la lectura no ocurrirá y la interrupción nunca se limpiará. El sistema se queda colgado sin reportar error.

Como red de seguridad, el firmware debe vigilar el nivel del pin: si pasan más de dos periodos sin interrupción pero el pin está abajo, se fuerza una lectura para destrabarlo.

Latencia de servicio medida: el ancho del pulso bajo de INT, que equivale al tiempo entre la detección y la limpieza por firmware, es de aproximadamente 3.5 ms con el bus a 100 kHz. Sobre una ranura de 23.28 ms eso es un 15 % de ocupación.

Nota de nomenclatura: «flanco de subida» y «flanco de bajada» en las secciones 7.1 y 8.3 se refieren a la distancia medida, no al nivel eléctrico del pin. Eléctricamente, todos los roles generan un flanco de bajada en INT cuando se cumple su condición de umbral.

## 9.5 Mitigaciones adicionales en firmware

- Corrección de sesgo de media ventana: el evento pudo ocurrir en cualquier punto de la ranura de medición, por lo que el instante se estima en el fin de ventana menos la mitad de la ranura real. Con la ranura medida de 23.28 ms (sección 9.2) la corrección es de 11.6 ms. Este valor debe recalcularse si se cambia el inter-measurement period: usar un número equivocado introduce un sesgo sistemático que no es visible en los datos. Pendiente: con el cambio de fase de ~9.9 ms en el cruce (sección 9.2), la ventana que precede a la detección puede no ser la ranura nominal. El valor se revisa cuando se conozca el mecanismo; el Experimento 1 no mide sesgo (sección 16.3).
- Interpolación del flanco: se conservan las muestras alrededor del cruce y se interpola linealmente el instante de detección. NO VERIFICADA: la magnitud de la mejora depende del número de muestras disponibles durante el cruce, que son aproximadamente 3 (sección 9.3). Una mejora de un orden de magnitud no es alcanzable con esa cantidad. Esta mitigación se mide en el Experimento 1 ejecutando el sensor en modo sample-ready con traza, lo que permite calcular de la misma corrida la σ del cruce por umbral y la del flanco interpolado. El beneficio real no debe darse por supuesto en el presupuesto de la sección 6.
- Traza de contexto: cada evento transmitido incluye un buffer circular con las últimas ~10 muestras de distancia y tiempo (≈80 bytes). Permite post-analizar detecciones anómalas, identificar disparos por extremidad y depurar en campo sin adivinar.
- Bloqueo temporal (lockout) de ~300 ms tras cada disparo válido para rechazar detecciones múltiples por extremidades. Equivale a 13 ranuras de medición de 23.28 ms.

# 10. Arquitectura de tiempo

## 10.1 Las dos arquitecturas posibles

Existen dos formas de construir un cronómetro distribuido, y la elección determina si la latencia del enlace inalámbrico contamina o no la medición.

Arquitectura | Mecanismo | Consecuencia
A — Timestamp central | Los nodos envían un aviso de evento; el receptor marca la hora de llegada | La latencia del radio entra directo a la medición. Una latencia constante se cancela al restar, pero el jitter (reintentos, colisiones en 2.4 GHz) no. Es irrecuperable.
B — Timestamp distribuido | Cada nodo marca la hora con su propio reloj; los relojes se mantienen alineados | SELECCIONADA. El paquete puede tardar 3 ms o 200 ms sin efecto alguno: el instante ya quedó congelado correctamente.

La versión 1.0 había seleccionado la arquitectura A citando el riesgo de deriva de reloj (clock drift). Ese riesgo estaba mal calibrado. Un cristal de ESP32 tiene una tolerancia del orden de ±40 ppm; en una corrida de 5 segundos eso equivale a 200 microsegundos, cien veces menor que la resolución de muestreo del sensor. La deriva no es el problema.

## 10.2 Offset y deriva

Un ESP32 no conoce la hora: mantiene un contador de microsegundos que arranca en cero al encender. Si el nodo A se enciende 3.2 segundos antes que el B, en un mismo instante real A reporta 10.000 s y B reporta 6.800 s. Ninguno está equivocado. Esa diferencia constante es el offset.

El offset puede ser de segundos o minutos, pero es medible y estable. Se mide con un intercambio ping-pong de cuatro timestamps entre nodos, cuya formulación cancela la latencia del enlace.

La deriva es el cambio lento del offset debido a que los cristales no corren a la misma velocidad. Entre dos cristales la diferencia relativa puede llegar a ~35 ppm, es decir 35 µs por segundo transcurrido.

Tiempo desde el último resync | Error acumulado por deriva
1 segundo | ~35 µs
30 segundos | ~1 ms
5 minutos | ~10 ms
30 minutos | ~63 ms — inaceptable

Decisión: resincronización cada 30 segundos mientras el sistema está en modo armado. Con esa cadencia la deriva se mantiene por debajo de 1–2 ms, dentro del presupuesto de error de la sección 6. La implementación es puramente de firmware y no requiere hardware adicional.

# 11. Comunicación y energía

## 11.1 Enlace entre nodos

ESP-NOW, protocolo de capa 2 nativo del ESP32, sin router ni infraestructura. Latencia típica de 1–4 ms, alcance en línea de vista muy superior a los 36.6 m del carril con antena externa SMA. Dado que la arquitectura de tiempo es distribuida, la latencia y su variabilidad no afectan la medición; el enlace sólo necesita ser fiable en entrega, no rápido.

Cada nodo mantiene contadores de paquetes enviados, confirmados y reintentados, y registra el RSSI de cada transmisión. Estos datos se incluyen en el CSV crudo para hacer medible el requisito REQ-NF-03 y permitir depuración de fallas intermitentes en campo.

## 11.2 Arquitectura de energía

Cada módulo opera con una celda recargable Li-ion 18650 (3.7 V nominal), regulada a un riel de 3.3 V mediante un convertidor buck-boost clase TPS63020.

Justificación técnica: una celda Li-ion recorre una porción significativa de su descarga por debajo de 3.3 V. Un regulador LDO no puede mantener regulación en todo ese rango, lo que reduciría la capacidad utilizable de la batería y aumentaría el riesgo de brownouts durante las transmisiones del ESP32. El ESP32 demanda picos rápidos de corriente durante actividad de radio; el factor limitante es la impedancia transitoria de la fuente, por lo que se priorizan trazas cortas, plano de tierra sólido y capacitores de desacoplo cerca de los pines de alimentación.

Evidencia del Experimento 0b (provisional): con el SoftAP activo, tres teléfonos conectados y la página de prueba descargándose cerca de una vez por segundo, el hub alimentado por USB desde una laptop conectada a la corriente entró en un bucle de 422 reinicios por el detector de brownout. Una hora antes la misma carga no lo había provocado, y la repetición del día siguiente tuvo un solo reinicio al abrir el puerto serial. La causa física (puerto, cable o fuente) no se aisló. Es la primera evidencia medida de que el hub bajo carga web es el caso crítico del riel de 3.3 V: las capturas de la sección 20 se hacen en el hub con esa carga, alimentado por USB y por la celda 18650.

Autonomía: un ESP32 con ciclo de trabajo de sensado y radio consume del orden de 120 mA promedio. Una celda 18650 de 2500 mAh entrega más de 15 horas teóricas, muy por encima del requisito de 1 hora. El riesgo de autonomía, señalado como alto en la versión 1.0, se reclasifica a bajo.

Riesgo de seguridad no documentado en versiones anteriores

Celdas Li-ion sin circuito de protección, cargándose dentro de un gabinete sellado impreso en 3D, sin fusible y sin corte por sobredescarga, constituyen un riesgo físico real. El diseño debe incluir celdas protegidas o circuito de protección discreto (TP4056 + DW01), fusible resettable (PTC), protección de polaridad inversa y una regla operativa explícita de no cargar en campo ni con el gabinete cerrado.

# 12. PCB y consideraciones de manufactura

Un único diseño de PCB replicado en los cuatro dispositivos, con el rol definido por jumpers leídos por el firmware al arrancar. Esto elimina variantes de hardware, permite un solo binario de firmware, hace intercambiables las unidades en campo y habilita la promoción de cualquier nodo al rol de hub (REQ-F-08).

## 12.1 Contenido de la placa

Bloque | Contenido
Cómputo | Módulo ESP32-WROOM-32UE soldado (ADR-013), con conector U.FL para la antena; circuito de arranque (EN e IO0) según el diseño de referencia ESP32-DevKitC; jumpers o DIP switch de selección de rol
Energía | Cargador con integrados (TP4056 + DW01A + FS8205A) y buck-boost TPS63021 de 3.3 V fijos (ADR-013), en lugar de módulos; un solo USB-C para cargar y programar (CH340C con auto-reset), cuyos 5 V van solo al cargador; conector polarizado de batería; conector de botón de encendido; bulk 470 µF y desacoplo 1 µF / 100 nF cerca del ESP32
Protección | MOSFET-P de polaridad inversa; fusible PTC resettable; diodo TVS en entrada de batería
Sensor | Conector polarizado de 6 vías hacia el gabinete del sensor (VIN, GND, SDA, SCL, INT, XSHUT); resistencias serie de 22–33 Ω en SDA y SCL; MOSFET de load switch para poder reiniciar el sensor por firmware. XSHUT debe llegar a un GPIO del ESP32: sin él no hay forma de recuperar un sensor colgado por software, ni de asignar direcciones I2C distintas a dos sensores en el mismo bus.
Interfaz | LED indicador con resistencia serie de 100 Ω; buzzer pasivo (poblado sólo en el hub); botones (sin poblar en nodos sensores)
Depuración | Test points expuestos en 3.3 V, GND, SDA, SCL, INT y XSHUT

Por qué XSHUT es obligatorio. Dos razones independientes, y cualquiera de las dos bastaría. Recuperación: durante las pruebas el sensor quedó colgado dos veces; el reset de la librería va por I2C, así que no sirve cuando el chip no responde, y sin XSHUT la única salida es cortar la alimentación a mano, inviable en campo con cuatro nodos en trípodes. Experimento 1: es la única forma de dar direcciones I2C distintas a dos sensores en el mismo bus.

## 12.2 Reglas de diseño

- Zona de keep-out libre de cobre, pistas, vías y componentes alrededor de la región de antena.
- Capacitores de desacoplo lo más cerca posible de los pines de alimentación del ESP32, con lazos mínimos y retorno directo al plano de tierra.
- Capacitancia bulk cerca del ESP32 para abastecer localmente los picos de corriente durante actividad de radio.
- Pista troncal de 3.3 V de 32 mil con recorrido corto desde el regulador; señales de sensor de 10 mil, ruteadas lejos del nodo de conmutación del buck-boost y de la región de antena.
- Verificar si el módulo del sensor ya incorpora pull-ups de I2C. Si los trae, no duplicarlos en la PCB: dos pares en paralelo reducen la resistencia efectiva y pueden sacar el bus de especificación.
- Medir físicamente con calibrador el breakout del sensor antes de finalizar footprints y keep-outs, dado que sus dimensiones publicadas no son confiables. El cargador y el buck-boost ya no son módulos genéricos (ADR-013).
- Una sola fuente en el riel de 3.3 V: el ESP32 se alimenta siempre de la batería a través del buck-boost. Los 5 V del USB-C van solo al cargador y el CH340C se alimenta del riel de 3.3 V (ADR-013). Para programar, el interruptor debe estar encendido.
- XSHUT se maneja soltando el pin en alta impedancia para liberarlo, nunca forzándolo a nivel alto. El pin no es tolerante a 5 V y el módulo ya lo lleva en pull-up. La secuencia de reset es: configurar como salida y poner en bajo, esperar 10 ms, reconfigurar como entrada y esperar 5 ms. El boot del sensor tarda 1.2 ms como máximo.
- Velocidad del bus I2C: 100 kHz validados en protoboard. A 400 kHz el bus resultó inestable en ese montaje, con lecturas de registro que devolvían cero. PROVISIONAL: la medición se hizo con jumpers largos y los pull-ups del módulo genérico. Sobre la PCB, con trazas cortas y pull-ups dimensionados, 400 kHz probablemente sea viable y debe volver a caracterizarse. Reducir la velocidad del bus baja la latencia de servicio de la ISR pero no afecta la medición, porque el timestamp se captura antes de tocar el bus.

## 12.3 Serigrafía y control de versiones

- Nombre del proyecto, número de versión de la placa y fecha.
- Etiqueta en cada conector, indicando función y marcador de pin 1.
- Tabla de configuración de jumpers de rol impresa sobre la placa.
- Nombre del autor y URL del repositorio público.

## 12.4 Gabinete y exposición ambiental

Problema | Mitigación
Temperatura interna | Una caja cerrada al sol de CDMX alcanza 60–70 °C. El ESP32 tolera hasta 85 °C, pero cargar Li-ion por encima de 45 °C la degrada y por encima de 60 °C es peligroso. Gabinete de color claro y prohibición operativa de cargar en campo.
Condensación | Los ciclos térmicos de una caja sellada succionan aire húmedo por micro-fugas. Instalar membrana de venteo (tipo breather vent) más sobre desecante.
Ventana del sensor | Colocar material transparente frente al ToF genera crosstalk óptico que invalida las lecturas. Ejecutar el procedimiento de calibración de cover-glass del fabricante con el air gap definido, antes de cerrar el diseño mecánico. Alternativa: abertura sin ventana, sellada con anillo de goma contra el propio módulo.
Daño mecánico a la antena | Evaluar refuerzo y alivio de tensión según comportamiento observado en transporte y campo.

## 12.5 Fabricación

- Ordenar 5 placas, no 4. Los lotes mínimos suelen ser de 5 y conviene tener una unidad de sacrificio.
- Dos capas es suficiente. No pagar cuatro capas.
- Mantener carpeta hardware/ con gerbers, BOM con designadores y códigos LCSC, y archivo de pick-and-place: el ensamble SMD lo hace el fabricante (JLCPCB o similar), con todas las piezas SMD en una sola cara (ADR-013).
- Criterio de verificación previo al envío a fabricación: debe ser posible energizar la placa y verificar todos sus subsistemas sin el gabinete montado.
- Comparar proveedores considerando costo, tiempo de entrega y practicidad. El tiempo de entrega es una restricción real del proyecto y puede justificar un proveedor más caro.

# 13. Arquitectura de software

## 13.1 Principio de separación

El sistema tiene dos productos con requisitos opuestos, y la arquitectura los separa deliberadamente.

Dimensión | Retroalimentación en campo | Análisis
Cuándo | Inmediato, ≤ 2 s | Diferido
Dónde | Junto al atleta | En cualquier lugar
Qué requiere | Mostrar un número | Procesamiento de datos y gráficas
Si falla | Se rompe la sesión de entrenamiento | Se revisa al día siguiente
Conectividad | Debe operar sin internet | Puede requerir internet

Regla arquitectónica

La nube nunca está en la ruta de medición. El cronometraje ocurre de forma completa y local entre los nodos y el hub. El internet en un campo deportivo vía hotspot de celular no es confiable, y perder tiempos por una caída de red constituye una falla de producto.

## 13.2 Firmware

Un único binario para los cuatro dispositivos. Al arrancar, el firmware lee los jumpers de rol y configura su comportamiento en consecuencia.

- Sensado: configuración del VL53L1X en modo continuo de corta distancia con interrupción por umbral; captura de timestamp en la ISR; buffer circular de muestras de contexto.
- Sincronización: protocolo ping-pong de resincronización de reloj cada 30 s en modo armado.
- Comunicación: transmisión de eventos por ESP-NOW; contadores de entrega y registro de RSSI.
- Agregación (rol hub): recepción de eventos de las cuatro puertas, aplicación de offsets, cálculo de splits, almacenamiento local.
- Servidor (rol hub): SoftAP, servidor HTTP, API mínima de resultados y configuración.
- Persistencia: buffer circular en RAM y, si se pueblan los headers, tarjeta SD. Se requiere al menos uno de los dos para cumplir REQ-NF-07.

Aislamiento de núcleos: el ESP32 es de doble núcleo. Se fija la tarea de sensado y timestamping en un núcleo y la actividad de radio en el otro, de modo que las ráfagas de transmisión no introduzcan jitter en la medición. Los callbacks de ESP-NOW se limitan a encolar; el procesamiento ocurre en la tarea propia.

Evidencia del Experimento 0b: con el firmware de experimento, sin aislamiento de núcleos, el hub cumplió REQ-NF-02 con margen de 10× mientras servía la página a tres teléfonos. El aislamiento deja de ser necesario para cumplir el requisito y queda como opción. El efecto medible de la carga web apareció en el resync: las ráfagas cuyo mejor round-trip pasa de 3 ms suben de 14 % a 30 %. Antes que aislar núcleos se evaluará repetir esas ráfagas (ADR candidato, sección 18).

## 13.3 Página web local

Servida por el hub en modo SoftAP. El coach se conecta a la red del sistema desde su teléfono y abre la página en el navegador. No se requiere router, hotspot, internet ni instalación de aplicación alguna.

Aspecto | Especificación
Volumen de datos | 30 atletas × 5 corridas × ~80 bytes ≈ 12 KB. El ESP32 dispone de 520 KB de RAM y 4 MB de flash.
Clientes simultáneos | El SoftAP soporta 4–8; el uso previsto es de 1 a 2.
Restricción crítica | El teléfono conectado al SoftAP no tiene internet. Todo el HTML, CSS y JavaScript debe residir en el flash del ESP32. Sin CDN, sin frameworks remotos, sin fuentes externas.
Implementación | HTML, CSS y JavaScript planos en un solo archivo, del orden de 20 KB.
Funciones | Selección de atleta, armado del sistema, resultado en vivo, tabla de la sesión ordenada, configuración de distancias de puertas, descarga de CSV.

## 13.4 Backend en la nube (fase posterior, no bloqueante)

Cuando exista conectividad, el hub sincroniza el histórico mediante un patrón de store and forward. El backend aloja el histórico multi-sesión, las gráficas de progreso, las comparativas entre atletas y el ajuste del modelo de velocidad. Esta capa no tiene requisitos de tiempo real ni de operación sin internet, por lo que su desarrollo puede apoyarse en herramientas de generación asistida sin comprometer el riesgo del proyecto.

## 13.5 Organización del repositorio

- firmware/ — código de los nodos, binario único con selección de rol
- webapp/ — página local embebida en el flash del hub
- cloud/ — backend y frontend de análisis (fase posterior)
- hardware/ — diseño de PCB, gerbers, BOM con designadores, modelos del gabinete
- docs/ — este documento, ADRs, guía de ensamble, procedimientos de calibración
- docs/history/ — documentación obsoleta conservada como registro de decisiones
- tools/ — scripts de análisis, procesamiento de los experimentos de validación

# 14. Análisis de datos

## 14.1 Qué información aporta cada tramo

Tramo | Qué mide | Uso para el coach
0–10 yd | Aceleración y capacidad de salida | Correlaciona con fuerza de piernas. Es el componente más entrenable.
10–20 yd | Fase de transición | El atleta sigue acelerando hacia su velocidad máxima.
20–40 yd | Velocidad máxima (flying 20) | Aproxima el techo de velocidad del atleta.

La conclusión más valiosa no es el tiempo total sino la comparación entre tramos. Dos atletas con el mismo tiempo de 40 yardas pueden ser deportistas muy distintos: uno rápido en 0–10 y lento en 20–40 es un arrancador explosivo cuyo margen de mejora está en velocidad máxima; el inverso es un velocista puro cuyo margen está en la salida. Esa distinción cambia el plan de entrenamiento y la asignación de posición, y constituye el valor real del producto.

## 14.2 Modelo biomecánico de sprint

Con cuatro puntos de tiempo por corrida es posible ajustar el modelo mono-exponencial de velocidad usado en la literatura de ciencias del deporte, en el que la velocidad instantánea se aproxima como la velocidad máxima multiplicada por (1 menos la exponencial negativa del tiempo dividido entre una constante de aceleración).

El modelo tiene dos parámetros: la velocidad máxima teórica y la constante de tiempo de aceleración. Con tres splits el sistema queda sobredeterminado y puede ajustarse por mínimos cuadrados. El resultado son dos números por atleta que resumen su perfil de sprint de forma mucho más informativa que los tiempos crudos, y que son directamente comparables a lo largo de la temporada.

Esta capacidad es puramente de software y no implica costo adicional de hardware. Constituye el principal diferenciador técnico del proyecto frente a un cronómetro convencional.

## 14.3 Procesamiento

- Ordenamiento por identificador de corrida y distancia para garantizar cálculos deterministas basados en diferencias.
- Cálculo por tramo de tiempo, distancia, velocidad media y aceleración, con protección ante tiempos cero o valores no numéricos, asumiendo velocidad inicial nula en el primer tramo.
- Métricas resumen por corrida en tabla separada: distancia total, tiempo total, velocidad pico y velocidad promedio.
- Suavizado de curvas de velocidad mediante interpolación PCHIP, que preserva la forma y evita los artefactos de sobreimpulso de los splines cúbicos.
- Gráficas a nivel de corrida (velocidades medidas más curva suavizada, con referencias de promedio y pico) y a nivel de atleta (velocidad promedio por distancia a través de varias corridas).

# 15. Lista de materiales y presupuesto

El BOM se recalcula para la configuración de cuatro puertas. Se corrigen tres errores presentes en la versión 1.0: la cantidad de sensores (el paquete es de 4, no de 3), el etiquetado invertido de los capacitores de desacoplo y bulk, y la omisión completa de los costos de fabricación de PCB y logística.

## 15.1 Componentes

Componente | Unitario | Piezas | Total | Nota
ESP32-WROOM-32UE | $120.00 | 4 | $480.00 | Soldado en la PCB (ADR-013)
Antena SMA 2.4 GHz | $31.00 | 4 | $124.00
Sensor ToF VL53L1X | paquete | 4 | $557.06 | Paquete de 4 con envío
Regulador buck-boost TPS63020 | $110.50 | 4 | $442.00 | TPS63021 soldado (ADR-013); precio a confirmar en LCSC
Pila Li-ion 18650 | $73.00 | 4 | $292.00 | Con protección
Portapilas 18650 | $12.00 | 4 | $48.00
Módulo de carga Li-ion | $10.00 | 4 | $40.00 | Pasa a TP4056 + DW01A + FS8205A soldados (ADR-013)
Conector USB-C | $12.00 | 4 | $48.00
Botón de encendido | $12.00 | 4 | $48.00
Capacitor bulk 470 µF | $2.00 | 4 | $8.00 | Corregido
Capacitor desacoplo 1 µF | $2.00 | 4 | $8.00 | Corregido
LED indicador + resistencia 100 Ω | $1.60 | 4 | $6.40
Buzzer pasivo | $16.00 | 1 | $16.00 | Sólo hub
Prensaestopas (cable gland) | $7.00 | 8 | $56.00
Cable de 6 hilos | $31.00 | 1 | $31.00
Headers hembra y macho | — | 6 | $40.00 | Ya no para el ESP32 (ADR-013); solo pruebas
Conectores y terminales Dupont | — | — | $10.50
Gabinete IP | $108.00 | 4 | $432.00
Cable Micro USB | $18.00 | 1 | $18.00
Membrana de venteo | $40.00 | 4 | $160.00 | Nuevo
Desecante | — | — | $30.00 | Nuevo
Protección eléctrica (MOSFET, PTC, TVS) | $20.00 | 4 | $80.00 | Nuevo
Jumpers de selección de rol | $5.00 | 4 | $20.00 | Nuevo

Subtotal de componentes: $2,994.96 MXN

## 15.2 Fabricación y logística

Concepto | Estimado | Nota
Fabricación de PCB (5 unidades) | $600.00 | Estimado sin ensamblado. Con ensamblado SMD y CH340C (ADR-013) sube: pendiente de cotización real en JLCPCB
Envío y trámites de importación | $200.00 | Omitido en el BOM v1.0

Total estimado del proyecto: $3,794.96 MXN

Desviación respecto al objetivo original

El objetivo de diseño de la versión 1.0 era de aproximadamente $2,500 MXN. El total actual lo excede en un 52 %. La causa principal no es el crecimiento del alcance sino que el presupuesto original omitía la fabricación de la PCB y la logística, y contenía errores aritméticos. Se recomienda revisar el objetivo a $3,800 MXN. Si es necesario reducir, la vía con mejor relación de ahorro es imprimir los gabinetes en 3D en lugar de comprar cajas IP comerciales, lo que libera del orden de $350 MXN.

## 15.3 Herramienta (no forma parte del BOM)

Herramienta | Estimado | Justificación
Analizador lógico USB 8 canales | $150.00 | Permite observar el bus I2C decodificado y el pin INT en el tiempo. Es la compra con mayor retorno del proyecto.
Multímetro | $250.00 | Verificación de rieles y consumo
Protoboards, jumpers, componentes surtidos | $320.00 | Prototipado previo a la PCB
Cables USB | $80.00

# 16. Plan de validación experimental

La validación precede a la fabricación. El objetivo de esta secuencia es descomponer experimentalmente el presupuesto de error de la sección 6, de modo que cada cifra pueda respaldarse con datos medidos en lugar de estimaciones de hoja de datos.

## 16.1 Experimento 0 — Jitter de la infraestructura de tiempo

Objetivo: cuantificar el error introducido por la sincronización de relojes y el timestamping, aislado de cualquier efecto del sensor.

Principio metrológico: para medir el error de un sistema se requiere una referencia más exacta que el sistema medido. Un evento eléctrico compartido por cable llega a ambos microcontroladores en nanosegundos, seis órdenes de magnitud por debajo del error buscado. El valor verdadero de la diferencia es cero; todo lo que no sea cero es error del sistema.

Montaje: un GPIO de salida del nodo A se conecta, a través de una resistencia de 330 Ω, tanto a un GPIO de entrada del propio A como a un GPIO de entrada del nodo B. Ambas placas comparten tierra de forma explícita. No se usa botón mecánico: los rebotes generan flancos espurios y el disparo por firmware permite automatizar 200 repeticiones.

Punto de falla más común

La tierra común es obligatoria. Dos placas alimentadas por fuentes USB distintas no comparten referencia de voltaje; sin unir explícitamente los GND, el cero volts de una no es el cero volts de la otra y las lecturas son inválidas.

Procedimiento: en ambos nodos, una ISR captura el tiempo local al detectar el flanco, con bloqueo de 50 ms. El nodo A, cada 500 ms y 200 veces, resincroniza con B, genera el pulso, recibe el timestamp de B por ESP-NOW, calcula la diferencia aplicando el offset y la registra por consola serial. Los 200 valores se exportan y se grafican como histograma.

Resultado (σ) | Interpretación y acción
≤ 2 ms | Infraestructura de tiempo excelente. Cumple REQ-NF-02 con margen. Avanzar.
2–10 ms | Usable pero mejorable. Revisar la cadencia de resincronización y el punto exacto de captura de los timestamps del ping-pong.
> 10 ms | Existe un defecto real. Causas probables: el timestamp se captura fuera de la ISR, o el cálculo del offset es incorrecto. No avanzar hasta resolverlo.
Media distinta de cero | Error sistemático en el cálculo de offset. Corregible, no bloqueante.

## 16.2 Experimento 0b — Jitter con el hub sirviendo la página web

Objetivo: medir si el hub sigue sincronizando igual de bien cuando, además de ESP-NOW, levanta el SoftAP, atiende teléfonos y envía resultados por WebSocket. El Experimento 0 se hizo con el radio dedicado solo a ESP-NOW.

Montaje: el del Experimento 0, sin cambios en la ISR, el resync ni la fórmula. Hub y nodo fijos en el canal 1. Página de prueba de 237 KB comprimida con gzip, con lastre aleatorio para que no se comprima a casi nada. 200 pulsos por corrida (23-oct-2026). Como cada corrida solo tiene 4 ráfagas de resync, se agregó una prueba de 100 ráfagas por condición (23 y 24-oct-2026).

Escenario | Resultado
C0: SoftAP apagado (dos corridas) | σ = 263 y 69 µs; 200/200 eventos en cada una
S1: SoftAP sin clientes | σ = 74 µs; 200/200
S2: 1 teléfono con WebSocket | σ = 402 µs; 200/200
S3: 1 teléfono descargando la página ~1/s + 2 escuchando (dos corridas) | σ = 147 y 488 µs; 200/200; 0.94 descargas/s medidas en la segunda
Prueba de ráfagas sin carga | 100 ráfagas: 14 % con mejor round-trip > 3 ms; error del offset σ 260 µs, máximo 1 147 µs
Prueba de ráfagas con la carga de S3 | 100 ráfagas: 30 % > 3 ms (Fisher p = 0.010); error σ 217 µs, máximo 935 µs; 0.98 descargas/s

Resultado: cumple REQ-NF-02 en todos los escenarios. Peor σ 488 µs (margen 10×), peor error individual 1 147 µs (4.4×), cero eventos perdidos en 1 200 pulsos. El nodo de 40 yd puede ser meta y hub a la vez; no se requiere un quinto ESP32.

Hallazgo: la carga del SoftAP degrada el resync de forma medible. No sube el piso del round-trip (2 419 µs con carga, 2 432 µs sin ella) pero sí la cola: las ráfagas cuyo mejor ping pasa de 3 ms suben de 14 % a 30 %. En las 6 corridas la σ alta la produjo un solo bloque abierto por una ráfaga lenta, y una de esas ráfagas ocurrió sin SoftAP. Todo el error del offset cayó dentro de la cota (D − F)/2 en 200 de 200 ráfagas.

Lección de método: con 4 ráfagas por corrida, la σ de una corrida depende de la suerte de una ráfaga (el mismo control dio 263 y 69 µs). El criterio original, σ(S3) ≤ 1.5 × σ(C0), no se cumplió por esa razón y no es repetible. Para comparar condiciones del resync se usa la frecuencia de ráfagas lentas sobre unas 100 ráfagas.

Reporte completo: experimentos/exp0b/experimento0b_resultados.md.

## 16.3 Experimento 1 — Contribución del sensor

Se retira el cable y se colocan dos sensores VL53L1X coplanares apuntando a la misma puerta, uno conectado a cada nodo. Ambos observan el mismo cruce, por lo que el valor verdadero de la diferencia entre sus timestamps es cero por construcción, independientemente de la velocidad del blanco. Se repiten 200 pasadas y se construye el histograma equivalente.

Dado que el montaje contiene dos sensores independientes, la varianza medida incluye la contribución de ambos. La contribución de un sensor individual se obtiene como:

σ_sensor = √( (σ_exp1² − σ_exp0²) / 2 )

El factor 2 es obligatorio. Omitirlo sobreestima la contribución del sensor en un 41 %. Con σ_exp0 = 168 µs, el término del Experimento 0 es despreciable frente a la escala de milisegundos esperada del sensor.

Predicción previa a la medición: si el error del sensor está dominado por la cuantización de la ranura de medición, cada sensor presenta un error uniforme sobre ella, con σ = ranura / √12. Con la ranura medida de 23.28 ms (sección 9.2) eso da 6.72 ms por sensor, y la diferencia entre dos sensores independientes resulta en:

σ_exp1 = √2 × 6.72 ms = 9.5 ms

Ese valor supone ventanas de ancho uniforme. Si la tasa de intervalos anómalos medida en régimen inválido (sección 9.2) se mantiene a IMP = 25 ms, la predicción sube a 10.7 ms. Un resultado entre 9.5 y 10.7 ms es confirmación del modelo, no una desviación.

Actualización del 26-oct-2026 (la predicción de arriba no cambia): a IMP = 25 ms la tasa de anómalos sin blanco es 3.0–3.3 %, pero en cada cruce el intervalo que termina en la detección es el largo (~33.2 ms, sección 9.2). El experimento debe registrar ese intervalo en cada evento, para poder separar su efecto en la diferencia entre sensores.

Esta predicción se escribe ANTES de medir. Un resultado cercano a 9.5 ms confirma que la cuantización es el mecanismo dominante y valida el presupuesto de ±10 ms de la sección 6. Un resultado sustancialmente mayor indica un mecanismo adicional no contemplado y constituye un hallazgo, no un fracaso del experimento.

Evidencia previa a favor de la predicción: la cadencia del chip tiene un jitter medido de 10.6 a 315 µs según la corrida (sección 9.2), de uno a tres órdenes de magnitud por debajo de la escala del error esperado. No hay inestabilidad de reloj que pueda competir con la cuantización.

Condiciones del montaje:

- Ambos sensores deben estar coplanares y perpendiculares a la dirección de paso. Una separación longitudinal d entre ellos introduce un desfase real de d/v, que a velocidad constante es sesgo (inofensivo) pero se convierte en varianza si la velocidad del blanco cambia entre pasadas. Medir con calibrador la separación residual y registrarla.
- XSHUT de ambos sensores debe estar cableado a GPIOs distintos. Es la única forma de asignarles direcciones I2C distintas en el mismo bus: se arranca con los dos apagados, se levanta uno, se le cambia la dirección, y se levanta el otro.
- Control previo obligatorio: verificar interferencia mutua. Ambos sensores emiten a 940 nm apuntando al mismo punto. Tomar distancia con uno solo encendido, anotar media y desviación, encender el segundo y repetir. Si la lectura se degrada, separarlos unos grados angularmente y volver a verificar.
- El emparejamiento de eventos entre nodos NO puede hacerse por número de secuencia. En el smoke test se perdió el 0.5 % de las muestras por colisión entre la ISR y el procesamiento del loop; si un nodo pierde un evento, todos los pares posteriores quedan desfasados. El emparejamiento se hace por proximidad temporal: aplicar el offset de reloj y unir eventos que caigan dentro de una ventana de ±100 ms. Los no emparejados se cuentan como pérdidas, lo que de paso da un adelanto de REQ-NF-03.

Limitación declarada: este experimento mide varianza, no sesgo. Cualquier retardo sistemático común a ambos sensores se cancela en la resta y no es observable por este método. La corrección de media ventana descrita en 9.5 no queda validada aquí.

Con ambos histogramas el presupuesto de error queda descompuesto experimentalmente. Estos dos gráficos constituyen la evidencia técnica más valiosa del proyecto.

## 16.4 Experimento 2 — Caracterización solar y de alcance

Medición del alcance útil real del sensor y de la tasa de detección en los tres modos de distancia, a distintas horas del día y bajo distintas condiciones de iluminación, en la superficie real de uso. Este experimento define la distancia máxima de montaje y el ancho del carril que debe marcarse con conos. La decisión debe tomarse con dato medido, no con especificación de hoja de datos.

## 16.5 Experimento 3 — Calibración de ventana y geometría

Verificación del crosstalk óptico introducido por la ventana del gabinete y ejecución del procedimiento de calibración correspondiente. En paralelo, determinación empírica de la altura de montaje óptima observando la varianza de tiempos a distintas alturas con el mismo atleta.

## 16.6 Experimento 4 — Validación en campo

Corridas repetidas de atletas reales para verificar REQ-NF-01 (repetibilidad ≤ 0.05 s), REQ-NF-03 (tasa de detección), REQ-NF-04 (tiempo de instalación) y REQ-NF-05 (autonomía). Comparación documentada contra cronometraje manual para cuantificar el sesgo descrito en la sección 2.

# 17. Riesgos

Riesgo | Severidad | Mitigación
PCB en ruta crítica sin holgura para un respin | Alta | Validar toda la funcionalidad en protoboard antes de fabricar. La PCB es entregable de manufactura, no prerrequisito de validación. Ordenar 5 unidades. Con el módulo soldado (ADR-013) ya no se arregla cambiando una tarjeta: test points en cada riel, jumpers de 0 Ω para aislar bloques y revisión del esquemático contra la guía antes de rutear.
Crosstalk óptico de la ventana del gabinete | Alta | Experimento 3 antes de cerrar el diseño mecánico. Alternativa sin ventana.
Degradación del sensor bajo sol directo | Alta | Experimento 2. Modo de corta distancia, montaje inclinado con fondo nulo, caracterización a distintas horas.
Seguridad de las celdas Li-ion | Alta | Celdas protegidas, PTC, protección de polaridad, prohibición de carga en campo y con gabinete cerrado.
El nodo de meta concentra meta y hub (SPOF) | Media | Jumpers de rol permiten promover cualquier nodo a hub y operar en modo degradado.
Brownout del hub con el SoftAP cargado | Media | Observado en banco con USB (422 reinicios, Exp. 0b). Capturas del riel de 3.3 V del hub con carga web; margen del regulador y desacoplo en la PCB; repetir con celda 18650.
Atleta fuera del alcance del sensor | Media | Carril marcado con conos; caracterización de modos medio y largo como margen.
Disparo por extremidad | Media | Montaje a altura de cadera; lockout temporal; traza de contexto para post-análisis.
Pérdida de datos por caída de conectividad | Media | Buffer local obligatorio y patrón store and forward. La nube nunca en ruta de medición.
Condensación dentro del gabinete | Media | Membrana de venteo y desecante.
Variabilidad dimensional de módulos genéricos | Baja | Reclasificado a baja: el cargador y el buck-boost pasan a integrados (ADR-013). Queda el breakout del sensor: medición con calibrador antes de finalizar footprints.
Ruido de conmutación del buck-boost acoplado a I2C o RF | Media | Disciplina de ruteo: alejar el nodo de conmutación de las líneas I2C y de la región de antena.
Presupuesto excedido en 52 % | Media | Revisar objetivo a $3,800 MXN o imprimir gabinetes en 3D.
Confiabilidad del enlace inalámbrico | Baja | Reclasificado a baja: la arquitectura de timestamp distribuido elimina la sensibilidad a la latencia. Sólo se requiere entrega eventual.
Autonomía de batería | Baja | Reclasificado a baja: el margen calculado es superior a 15×.
Degradación del resync por la carga del SoftAP | Baja | Medida en el Exp. 0b: ráfagas lentas 14 % → 30 %, error dentro de REQ-NF-02 con 10×. Mitigación candidata: repetir las ráfagas con mejor round-trip > 3 ms.

# 18. Registro de decisiones de arquitectura

Cada ADR debe redactarse como documento independiente en docs/adr/ siguiendo el formato: contexto, decisión, alternativas consideradas, consecuencias. Las decisiones ya tomadas en este documento son las siguientes.

ID | Decisión | Justificación central
ADR-001 | Descartar identificación por RFID | Costo prohibitivo frente al presupuesto objetivo y complejidad operativa de los tags. La selección manual desde la interfaz web cubre el requisito.
ADR-002 | Eliminar el servidor en campo (Orange Pi / laptop) | El ESP32 en modo SoftAP satisface el requisito de retroalimentación en campo con margen de 40× en memoria, a un quinto del costo y sin riesgo de corrupción de sistema de archivos.
ADR-003 | Timestamp distribuido en lugar de central | La deriva de cristal en 5 s es de 200 µs, cien veces menor que la resolución de muestreo. El jitter del radio, en cambio, es irrecuperable. El riesgo estaba mal calibrado en v1.0.
ADR-004 | Disparo de inicio por levantamiento de mano | Es el único evento discreto y bien definido disponible. Reduce el error de la puerta de inicio de ±50 ms a ±20 ms, y el inicio contamina todos los splits.
ADR-005 | Montaje a la altura de la cadera | La cadera es el punto de mínima varianza del cuerpo en carrera. Manos y pies adelantan 45–50 cm de forma variable según la fase de zancada.
ADR-006 | Modo de corta distancia e inclinación ascendente | Doble motivación coincidente: inmunidad a luz ambiente en 940 nm y timing budget mínimo. La inclinación produce un fondo nulo que convierte la detección en un evento binario limpio.
ADR-007 | Enlace inalámbrico pese a ser métricamente inferior | El cableado eliminaría 1–2 ms, el 3 % del error total, a cambio de 80 m de cable, 20 minutos adicionales de instalación y riesgo de tropiezo. Viola REQ-NF-04.
ADR-008 | Cuatro puertas fijas en lugar de tres con split móvil | Un dash es esfuerzo máximo: un atleta rinde 4–6 repeticiones de calidad por sesión. Componer un perfil a partir de dos corridas distintas consume el doble de repeticiones y asume una consistencia que el atleta no tiene. El cuarto sensor ya estaba pagado en el paquete de 4; el costo incremental real es de aproximadamente $150 MXN.
ADR-009 | PCB única con rol definido por jumpers | Elimina variantes de manufactura, permite un binario único de firmware, hace intercambiables las unidades y habilita la promoción de cualquier nodo a hub como mitigación del SPOF.
ADR-010 | Distancias de puerta como parámetro configurable | Al ser inalámbricas, las puertas pueden reposicionarse libremente. Todo el análisis divide entre la distancia, por lo que un valor hardcodeado produciría velocidades erróneas indetectables desde los datos.

ADR-011

Inter-measurement period de 25 ms, no 20 ms

El periodo real de muestreo es IMP × 0.931. Con IMP = 20 ms la ranura (18.62 ms) no acomoda el timing budget (20.02 ms), el chip entrega cada dos ranuras y el periodo efectivo es de 37.24 ms, lo que llevaría la cuantización a 10.75 ms y excedería el presupuesto de la sección 6. Con IMP = 25 ms la ranura es de 23.28 ms, acomoda la medición con 0.94–2.8 ms de margen (confirmado en arranque en frío, 23-oct-2026), y la cuantización baja a 6.72 ms. El costo es nulo: es un parámetro de firmware. Confirmado en régimen sin retorno (24 y 26-oct-2026): 0 saltos a 2 ranuras en 2 076 intervalos con blanco y 3.0–3.3 % de anómalos sin blanco.
ADR-013 | Módulo ESP32 soldado y placa ensamblada por el fabricante | La tarjeta en headers dejaba dos fuentes en el riel de 3.3 V, footprints inciertos de módulos genéricos y una unión que se afloja con la vibración del tripié. Módulo WROOM-32UE soldado, cargador y buck-boost con integrados, un solo USB-C con CH340C y ensamblado SMD por el fabricante. Reemplaza la parte de la 12.1 y la 12.5 que pedía headers y ensamble manual. ADR-012 queda reservado para el reintento de ráfagas.

ADR candidato, pendiente de decisión: repetir una ráfaga de resync cuyo mejor round-trip supere ~3 ms. En el Experimento 0b el error del offset fue σ 58 µs (sin carga) y 93 µs (con carga) en las ráfagas ≤ 3 ms, contra 669 y 369 µs en las lentas. Ataca el mecanismo dominante con o sin WiFi y es más barato que aislar núcleos. Antes de registrarlo como ADR-012 falta fijar el umbral y el número de reintentos, y medirlo con la prueba de ráfagas.

# 19. Próximos pasos

1. Hecho (sep–oct 2026): kit de arranque, protocolo de resync, Experimento 0 (σ = 168 µs), smoke test y barridos del sensor, incluido el de arranque en frío, Experimento 0b (σ ≤ 488 µs con el hub sirviendo la página), corridas largas del sensor a IMP = 25 ms en régimen sin retorno (vidrio y cielo abierto), prototipo de la página web con datos simulados y ADR-013.
2. Cablear XSHUT en ambos nodos y verificar el reset por hardware.
3. Decidir el reintento de ráfagas de resync lentas (sección 18) y medirlo con la prueba de ráfagas del Experimento 0b.
4. Medir el riel de 3.3 V del hub con SoftAP y carga web, alimentado por USB y por celda 18650, antes de cerrar el regulador de la PCB (sección 11.2).
5. Ejecutar el Experimento 1 y obtener la contribución aislada del sensor. Predicción escrita de antemano: σ_exp1 = 9.5 ms con ventanas uniformes, 10.7 ms con la tasa de intervalos anómalos medida. Registrar en cada evento el intervalo previo a la detección (sección 9.2).
6. Ejecutar el Experimento 2 (caracterización solar) y fijar la distancia de montaje y el ancho del carril con dato medido.
7. Medir con calibrador el breakout del sensor y finalizar footprints y keep-outs de la PCB.
8. Incorporar al diseño de PCB las adiciones de la sección 12: protección eléctrica, test points, jumpers de rol, conectores polarizados, serigrafía.
9. Asignar códigos LCSC a cada pieza y cotizar 5 placas ensambladas (ADR-013); comparar contra el estimado de fabricación de la sección 15.2.
10. Desarrollar el firmware de sensado, timestamping y sincronización sobre protoboard, sin depender de la PCB.
11. Embeber la página web local en el hub (el prototipo con datos simulados está hecho) e implementar el contrato de webapp/PROTOCOLO.md en el firmware.
12. Adquirir el resto del BOM una vez confirmado el diseño final de la PCB.
13. Fabricar 5 placas, ensamblar, ejecutar pruebas eléctricas y montar en gabinete.
14. Ejecutar los Experimentos 3 y 4 en campo.
15. Desarrollar el backend de análisis en la nube.

# 20. Evidencia de portafolio planeada

- Histogramas de los Experimentos 0 y 1, con la descomposición del presupuesto de error, y la comparación de ráfagas de resync con y sin carga web del Experimento 0b. Ésta es la pieza técnica de mayor valor del proyecto.
- Capturas de osciloscopio del riel de 3.3 V durante eventos de transmisión del ESP32.
- Capturas del analizador lógico mostrando la transacción I2C y la activación del pin INT en el tiempo.
- Fotografías de la PCB mostrando la zona de keep-out de antena, la serigrafía con la URL del repositorio y la colocación final de componentes.
- Mediciones con calibrador y bocetos acotados de los módulos genéricos.
- Evidencia de impermeabilización: instalación del prensaestopas, membrana de venteo y resultados de pruebas de salpicado.
- Capturas de la página web local operando desde el teléfono, sin conexión a internet.
- Gráficas de perfil de velocidad con el modelo mono-exponencial ajustado sobre datos reales.
- Comparativa documentada contra cronometraje manual, cuantificando el sesgo de reacción humana.
- Video del sistema completo operando en campo con el coach utilizando la interfaz.

Fin del documento maestro. Toda modificación a la arquitectura aquí descrita debe registrarse como un nuevo ADR y reflejarse en una versión incrementada de este documento.

DASH Timing System — Documento Maestro v2.3 · Página 1 de 1
