agustinavelino/dash-40yd/experimentos/exp0/exp0_datos.csv

seq | resultado_us | offset_us
1 | -100 | 50999876
2 | -107 | 50999876
3 | -114 | 50999876
4 | -121 | 50999876
5 | -129 | 50999876
6 | -137 | 50999876
7 | -145 | 50999876
8 | -152 | 50999876
9 | -159 | 50999876
10 | -167 | 50999876
11 | -174 | 50999876
12 | -182 | 50999876
13 | -189 | 50999876
14 | -197 | 50999876
15 | -204 | 50999876
16 | -212 | 50999876
17 | -219 | 50999876
18 | -227 | 50999876
19 | -234 | 50999876
20 | -241 | 50999876
21 | -249 | 50999876
22 | -257 | 50999876
23 | -264 | 50999876
24 | -271 | 50999876
25 | -278 | 50999876
26 | -286 | 50999876
27 | -294 | 50999876
28 | -301 | 50999876
29 | -308 | 50999876
30 | -316 | 50999876
31 | -323 | 50999876
32 | -330 | 50999876
33 | -338 | 50999876
34 | -346 | 50999876
35 | -353 | 50999876
36 | -360 | 50999876
37 | -367 | 50999876
38 | -375 | 50999876
39 | -382 | 50999876
40 | -389 | 50999876
41 | -396 | 50999876
42 | -404 | 50999876
43 | -411 | 50999876
44 | -418 | 50999876
45 | -425 | 50999876
46 | -433 | 50999876
47 | -440 | 50999876
48 | -447 | 50999876
49 | -454 | 50999876
50 | -461 | 50999876
51 | -468 | 50999876
52 | -476 | 50999876
53 | -483 | 50999876
54 | -490 | 50999876
55 | -498 | 50999876
56 | -505 | 50999876
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
