agustinavelino/dash-40yd/experimento_0/03_presupuesto_error.png

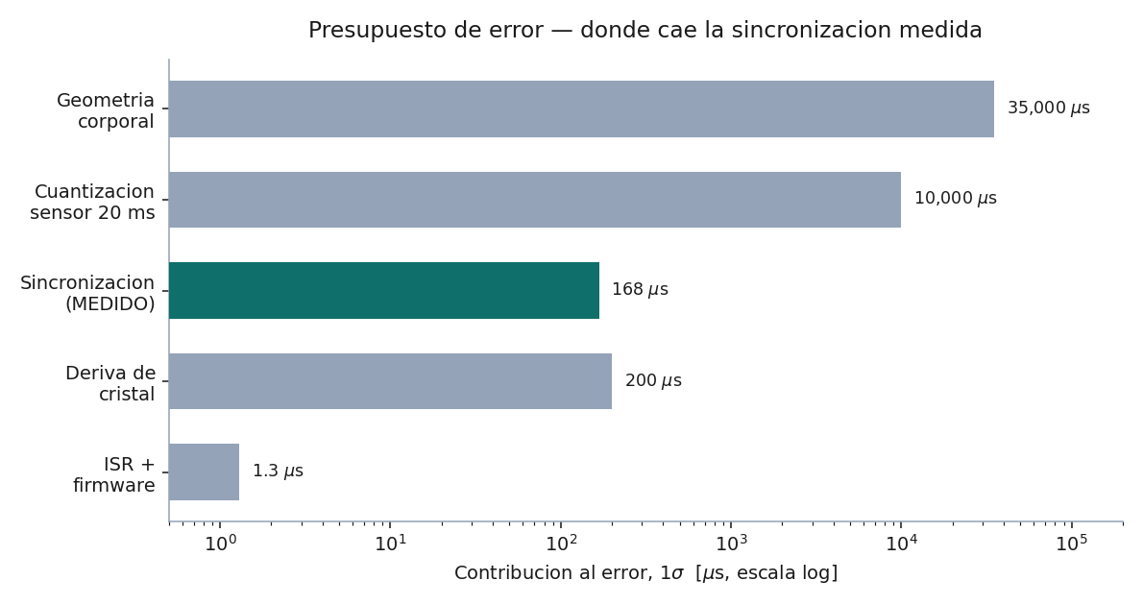
experimento_0/03_presupuesto_error.png
