agustinavelino/dash-40yd/experimento_0/04_filtro_latencia.png

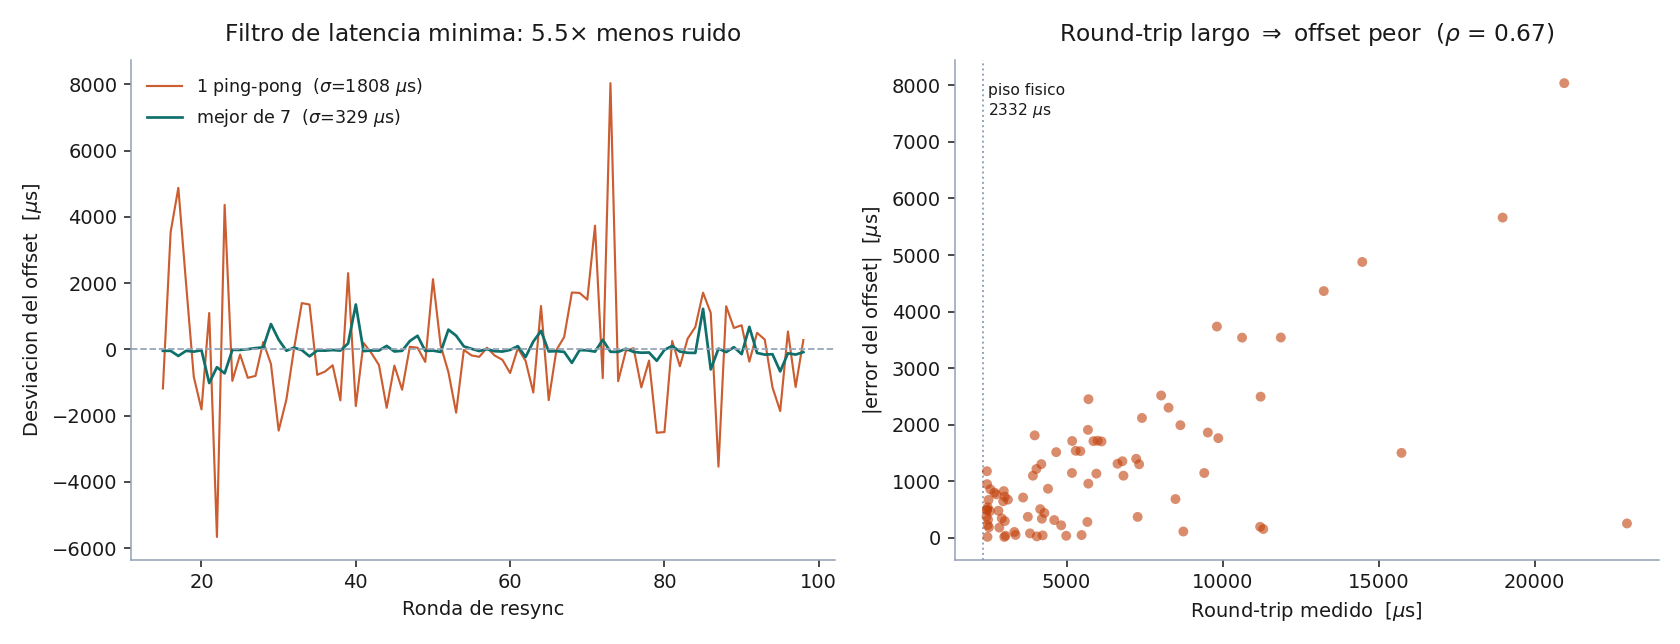
experimento_0/04_filtro_latencia.png
