agustinavelino/dash-40yd/(commit log)

2026-09-21 resultados y codigo para prueba 0
    [exp0_datos.csv]
2026-10-23 Reorganiza el repo en estructura híbrida (docs/ + experimentos/)
    Cada experimento queda autocontenido en experimentos/<id>/ para que el
    reporte y su evidencia no se separen. Se integra lo que venía de
    claude.ai (contexto/): Documento Maestro y plan del 0b a docs/, sketches
    del sensor a experimentos/sensor_vl53l1x/. Las copias de prueba_0_A/B y
    del reporte del Exp. 0 eran idénticas salvo CRLF y se eliminan.
    bitacora, prueba0 y algoritmo.py pasan a docs/history/.
2026-10-23 Agrega CLAUDE.md alineado con el repo y el toolchain real
    Describe la estructura real, el toolchain medido (WSL2 llamando a
    arduino-cli.exe y al Python de Windows para los COM) y las herramientas
    de Claude Code planeadas (agente de banco y skill de documentación).
2026-10-23 Corrige MAGIC del barrido v5: 0xDA5HC001 no es hex y no compilaba
    Era la razón por la que el v5 nunca se pudo correr. El valor es
    arbitrario (solo marca que la memoria RTC ya se inicializó), así que se
    cambia la H por A sin otro efecto. Compilado con core 3.3.11: 304 KB.
2026-10-23 Agrega scripts de banco: identificar puertos, logger serial y resumen
    Base para que un agente corra los experimentos desde WSL2: esptool lee
    la MAC de fábrica para no flashear la placa equivocada, el logger corre
    con el Python de Windows (único que ve los COM) y el resumen devuelve
    unas líneas en vez de la salida completa. Verificado: el resumen sobre
    exp0_datos.csv da sigma = 168 us, igual que el reporte.
2026-10-23 Agrega docs/ESTADO.md como tablero de avance
    Una sola fuente de estado con criterio de cierre por tarea. Registra que
    el ADR-011 depende del barrido v5. CLAUDE.md apunta al tablero y aclara
    que el .ino solo es punto de entrada (la lógica puede ir en .cpp/.h).
2026-10-24 Usa RTC_NOINIT_ATTR en el barrido v5 para que sobreviva a ESP.restart()
    RTC_DATA_ATTR se reinicializa en todo reinicio que no sea despertar de
    deep sleep, así que el v5 volvía siempre a la config 1 (97 arranques en
    10 min). NOINIT no se inicializa nunca; el MAGIC ya cubría la basura del
    encendido. No toca la medición.
2026-10-24 Datos crudos del barrido v5 en arranque en frío (23-oct-2026)
    IMP 25 -> 23.308 ms = 1.001 ranuras: el ADR-011 se sostiene en frío.
    11 configuraciones, 1320/1320 válidas, 0 anómalos, blanco a 1105 mm.
    Se conserva también el intento 1 (bucle en la config 1) como evidencia
    de la incidencia y de la repetibilidad a IMP 10.
2026-10-24 Actualiza el estado: S1 cerrada, ADR-011 confirmado en frío
    Registra la tabla del v5, la cota de la duración real de la medición
    (20.48 < T <= 22.34 ms, margen real a IMP 25 de 0.94-2.8 ms y no 3.3)
    y la alternativa IMP 12 como decisión abierta. Junta los cambios
    pendientes para la v2.2 del Documento Maestro.
2026-10-24 Agrega tools/ard.sh y filtra a puertos USB al identificar placas
    ard.sh evita repetir la ruta de arduino-cli.exe y la conversión wslpath,
    y recorta la salida de esptool. identificar_puertos ahora solo prueba
    los 'Serial Port (USB)': los demás COM de esta máquina no son ESP32 y
    costaban ~30 s cada uno (de ~2.5 min a 4.7 s).
2026-10-24 Agrega el agente runner y la skill documentar
    runner: ejecuta compile/upload/corridas, identifica placas por MAC antes
    de flashear y devuelve ~15 líneas para no saturar el contexto. Probado
    en seco: identificó el hub en COM7, compiló hub y nodo del Exp. 0 y se
    detuvo correctamente al faltar el nodo.
    documentar: reportes con el formato de experimento0_resultados.md, con
    la predicción citada sin cambios, y actualización de docs/ESTADO.md.
2026-10-24 Agrega hooks de datos crudos y webapp, y permisos del proyecto
    proteger_datos bloquea editar, truncar o borrar .csv/.txt existentes en
    experimentos/ (los datos crudos no se tocan). revisar_webapp avisa si
    webapp/ trae recursos externos o pasa de 30 KB (REQ-NF-08, 13.3).
    13/13 casos de prueba correctos.
2026-10-24 Documenta runner, skill y hooks en CLAUDE.md y actualiza el estado
2026-10-24 Agrega el reporte de caracterización del VL53L1X
    Junta smoke test, barrido v3 y barrido v5 con el formato del Exp. 0.
    Resultado: IMP 25 da 23.31 ms (1 ranura) en arranque en frío, así que el
    ADR-011 se sostiene; cuantización 6.73 ms, margen 1.5x sobre ±10 ms. El
    barrido acota la duración real de una medición (20.48-22.34 ms), por lo
    que el margen a IMP 25 es 0.94-2.8 ms y no 3.3. graficar_sensor.py
    calcula todos los números desde los crudos. .venv fuera de git.
2026-10-24 Actualiza estado y CLAUDE.md tras el reporte del sensor
    Cierra I3 (skill documentar), corrige el conteo del intento 1 del v5
    (92 mediciones completas, no 97) y agrega cambios para la v2.2 del
    Documento Maestro.
2026-10-24 Repetición del Experimento 0 por el runner: 200/200, sigma 87 us
    Reproduce el resultado del 20-sep (168 us) con la misma estructura de
    resync (seq 60/120/180). La sigma menor sale de una deriva de cristal
    menor hoy (9.4-10.6 contra 11.4-14.7 us/s); la referencia del
    presupuesto sigue siendo 168 us. Se conserva el intento 1 (193/200,
    media +3.5 s) que falló por flashear el nodo antes que el hub.
2026-10-24 Runner: orden hub -> nodo -> logger obligatorio; cierra I2
    El nodo acepta un solo handshake por arranque. Flasheando el nodo
    primero, el reinicio del hub al abrir el logger manda un segundo
    handshake que el nodo ignora y queda N pulsos adelantado. Queda escrito
    con su síntoma para reconocerlo.
2026-10-24 ard.sh acepta opciones de placa y defines; resumen muestra clientes_ws
    ARD_OPCIONES permite PartitionScheme=huge_app (el hub del 0b pesa 1.2 MB)
    y ARD_FLAGS pasa -DSOFTAP_ACTIVO=0 para el control C0 sin otro sketch.
    El resumen agrega la columna clientes_ws para comprobar que cada
    escenario tuvo los clientes que debía.
2026-10-24 Prepara el Experimento 0b: hub, nodo, página de prueba y procedimiento
    Hub y nodo parten de prueba_0_A/B sin tocar ISR, resync ni fórmula; lo
    agregado va marcado [0b]: SoftAP en canal 1 (C0 con -DSOFTAP_ACTIVO=0
    en el mismo canal), WebSocket enviado desde loop(), CSV extendido con
    rtt, pongs y clientes, y los round-trips de todas las ráfagas. Con
    SoftAP el hub espera 60 s o el botón Iniciar para que los teléfonos se
    reconecten tras el reinicio del logger. Página de 306 KB (237 KB gzip)
    con lastre aleatorio de semilla fija para que pese de verdad en el aire.
    Compilan las tres variantes con ESP Async WebServer 3.12.1 + Async TCP 3.5.0.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
2026-10-24 Registra librerías fijadas y el 0b listo para correr en el estado
2026-10-24 Exp. 0b: datos crudos del escenario C0 (control, SoftAP apagado)
    200/200 eventos, sigma 263 us, rtt elegido mediana 2515 us, 7/7 pongs.
    La sigma sale alta por el primer resync: sus 7 pings fueron lentos
    (mejor rtt 3634 us, cota ±651 us) y el bloque 1 arranca con -539 us de
    error; los bloques 2-4 arrancan en -7 a -27 us. Registra también que
    el usuario no hizo predicción para el 0b.
2026-10-24 Exp. 0b: datos crudos de los dos primeros intentos de S1
    Intento 1: el logger cortó a los 61 s porque '^# fin' también coincide
    con '# fin de espera'. Intento 2: corrida completa (sigma 98 us, rtt
    mediana 2681 us) pero con bytes corruptos en el serial en seq 55-58:
    dos filas ilegibles y una (seq 58) que pasó con rtt 981 en vez de 2981.
    Se conserva como evidencia; S1 se repite con checksum.
2026-10-24 Exp. 0b: checksum por línea y tabla duplicada; marcador de fin exacto
    Solo registro, la medición no cambia. Cada línea lleva '*HH' (XOR, como
    NMEA) y la tabla sale dos veces; resumen_corrida.py descarta las líneas
    que no cuadran y usa la primera copia válida de cada seq, así una
    corrupción del serial ya no se confunde con un evento perdido ni se
    cuela como dato válido. Marcador del 0b: '^# fin$'.
2026-10-24 Exp. 0b: datos crudos de S1 (SoftAP encendido, sin clientes)
    200/200 eventos válidos, sigma 74 us, media -160 us, rtt elegido
    mediana 2455 us, 7/7 pongs. Hubo una línea corrupta en cada copia de la
    tabla (seq 52 y 165) y ambas se recuperaron de la otra copia gracias al
    checksum. La corrupción del serial solo ha aparecido con SoftAP activo.
2026-10-24 Exp. 0b: datos crudos de S2 (SoftAP + 1 teléfono con WebSocket)
    200/200 eventos, 0 líneas corruptas, 1 cliente WebSocket en todos los
    eventos. sigma 402 us, dominada por la ráfaga 3: sus 7 pings fueron
    lentos (mejor rtt 4232 us, cota ±950 us) y el bloque arranca en +840 us;
    los otros tres bloques arrancan entre -1 y -52 us. Mismo mecanismo que
    la ráfaga 1 de C0, con SoftAP apagado.
2026-10-24 Exp. 0b: datos crudos de S3 (SoftAP + 3 teléfonos), carga por verificar
    200/200 eventos, sigma 147 us, 3 estaciones en el AP. Ráfaga 2 lenta
    (mejor rtt 3131 us, bloque arranca en -324 us); las otras tres limpias.
    Pendiente: clientes_ws fue 3 en 196/200 eventos con solo 8 cambios, lo
    que no cuadra con un teléfono recargando cada 1 s (su WebSocket debería
    caerse en cada recarga). Hay que confirmar si el modo estrés corrió.
2026-10-24 Exp. 0b: mide la carga de S3 y hace robusto el modo estrés
    En el primer S3 la carga no se pudo verificar desde el hub: clientes_ws
    se quedó en 3 aunque el teléfono hizo ~70 recargas con atorones, y tras
    el reinicio del hub hubo que recargarlo a mano (location.reload() deja
    la página de error del navegador si la descarga falla).
    - Hub: cuenta las descargas de '/' (columna paginas y total al final).
    Solo registro; la medición no cambia.
    - Página: el estrés baja la página completa con fetch en ciclo, hasta
    1/s, y reintenta si falla. Para el hub es la misma carga (237 KB gz).
    - resumen_corrida.py imprime la tasa de descargas.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
2026-10-24 Exp. 0b: datos crudos de S3 con carga medida (0.94 descargas/s)
    200/200 eventos, sigma 488 us, 94 descargas de la página en 100 s
    (22 MB gz). La sigma la domina la ráfaga 2: mejor rtt 4882 us, cota
    ±1275 us, el bloque arranca en +951 us; los otros tres bloques arrancan
    entre -34 y -174 us. 6 líneas corruptas, todas recuperadas.
    resumen_corrida.py: si el archivo usa checksum, una línea sin '*' se
    descarta. Antes se aceptaba como formato viejo, y una línea que perdía
    su checksum por corrupción podía pasar como válida.
2026-10-24 Exp. 0b: segundo C0 del día: sigma 69 us (el primero dio 263 us)
    Mismo firmware y montaje. Sin ráfaga mala (mejor rtt 2444 us mediana),
    0 líneas corruptas: la corrupción del serial sigue apareciendo solo con
    SoftAP activo. La diferencia 263 contra 69 us en el control muestra que
    con 4 ráfagas por corrida la sigma depende de la suerte de una ráfaga.
2026-10-24 Exp. 0b: agrega la prueba de ráfagas (MODO_RAFAGAS) y su análisis
    Con 4 ráfagas por corrida la sigma del 0b la decide la suerte de una
    (C0: 263 y 69 us el mismo día), así que no puede decir si el SoftAP
    degrada el resync. -DMODO_RAFAGAS=1 repite la misma hacerResync() 100
    veces, una cada 3 s, sin pulsos, con el mismo radio, servidor y carga
    de WebSocket. analizar_rafagas.py mide la frecuencia de ráfagas lentas
    y el error real del offset contra la recta de deriva. Se registra antes
    de correr que no hay predicción.
2026-10-24 Exp. 0b: prueba de ráfagas en C0 (100 ráfagas, SoftAP apagado)
    14/100 ráfagas con mejor rtt > 3 ms sin WiFi de por medio. El error del
    offset lo explica el rtt: sigma 66 us en las ráfagas <= 3 ms y hasta
    ±1123 us en las lentas, dentro de la cota (rtt - F)/2. El análisis
    separa ahora ráfagas buenas y malas; un ajuste de grado 2-3 da el mismo
    residuo que la recta, así que es error real y no curvatura de deriva.
2026-10-24 Exp. 0b: intento 1 de ráfagas en S3 abortado por brownout del hub
    La prueba arrancó (botón, 3 estaciones, 3 clientes WebSocket) y el hub
    entró de inmediato en un bucle de 422 reinicios por el detector de
    brownout: el pico de corriente del radio tira el voltaje de la
    alimentación USB. El S3 de 200 pulsos de hace una hora no lo tuvo, así
    que algo cambió en lo físico (puerto, cable o fuente). Sin datos de
    ráfagas válidos; se conserva como evidencia de energía.
2026-10-24 Exp. 0b: prueba de ráfagas en S3 (100 ráfagas, 0.98 descargas/s)
    Con la carga completa de S3 las ráfagas lentas (> 3 ms) suben de 14 %
    (C0) a 30 % (p = 0.006) y el mejor rtt mediano de 2486 a 2729 us
    (p < 0.001): la carga del SoftAP degrada el resync de forma medible.
    El error real del offset queda en sigma 217 us, máximo 935 us, dentro
    de la cota en 100/100 ráfagas. 1 brownout al abrir el puerto, sin bucle.
    El estado resume los resultados del 0b para el reporte.
2026-10-25 Exp. 0b: reporte de resultados (hallazgo) y estado actualizado
    El hub puede servir la página: sigma <= 488 us con SoftAP y 3
    teléfonos (REQ-NF-02 con 10x), 0 pérdidas. La carga sube las ráfagas
    de resync lentas de 14 % a 30 % (Fisher p = 0.010) sin mover el piso
    F; el error del offset queda dentro de la cota (rtt - F)/2 en 200/200
    ráfagas. graficar_exp0b.py genera las gráficas 01-04 y las tablas
    desde los CSV crudos. ESTADO cierra T1 y abre el ADR de reintento de
    ráfagas y la energía del hub.
2026-10-25 Documento Maestro v2.2: barrido v5 y Experimento 0b
    La v2.1 seguía con el margen de 3.3 ms y el jitter de 10.6 µs que el
    barrido en frío no reprodujo, y no tenía el Exp. 0b. La v2.2 agrega la
    sección 0.3 (cambios y firmeza), la 16.2 (Exp. 0b; los Exps. 1-4 pasan
    a 16.3-16.6), el margen real de IMP 25 (0.94-2.8 ms), la sincronización
    con carga web en el presupuesto, el aislamiento de núcleos como opción,
    dos riesgos (brownout del hub y resync con carga) y el ADR candidato de
    reintento de ráfagas. Ninguna decisión de arquitectura cambia. La v2.1
    se conserva en docs/ hasta decidir si se mueve a history/.
2026-10-25 Sensor: sketch y análisis de la corrida larga apuntando al cielo (I5)
    El ADR-011 solo está confirmado en régimen válido; las puertas pasan
    casi todo el tiempo en régimen inválido y a IMP 25 nunca se ha medido.
    corrida_cielo.ino captura 5000 interrupciones en arranque en frío con
    el range_status crudo y las imprime al final con checksum (IMP por
    -DIMP_MS para probar 26-28). analizar_cielo.py separa los intervalos
    por régimen y cuenta anómalos y saltos a 2 ranuras; probado con una
    captura sintética. Compila con core 3.3.11.
2026-10-25 S2: registra que no hay predicción antes de la corrida al cielo
2026-10-25 Sensor: corrida al cielo a IMP 25 (S2): 0 saltos a 2 ranuras, anómalos de ±9.5 ms
    5000 muestras con cortina a 2 m y 46 cruces. En válido, 0/587 anómalos y
    0 saltos a 46.6 ms. En inválido, 8.8 % de anómalos pero simétricos: un
    intervalo corto seguido de uno largo que suman 2 ranuras, con la fase
    dentro de ±10 ms. Cierra I5 y S2; el ADR-011 se sostiene.
2026-10-25 S2: marca el intento 1 como no válido y agrega LED de cruce con columna cue
    El LED integrado no se vio parpadear y los cruces fueron pocos, así que
    no se distinguen de lecturas intermitentes de la cortina (12.7 % de
    muestras válidas). Las cifras del intento 1 quedan como observación sin
    confirmar. El sketch enciende un LED externo en GPIO18 (y el integrado)
    1 s cada 4 s para cruzar, y registra ese estado en la columna cue;
    analizar_cielo.py compara válidas con el LED encendido y apagado.
2026-10-25 Sensor: corrida larga a IMP 25 con LED de cruce (S2): 0 saltos en válido
    Intento 3, con fondo de vidrio a ~2 m y 31 cruces guiados por el LED.
    Régimen válido: 1054 intervalos sin anómalos ni saltos a 46.6 ms; el
    ADR-011 se sostiene. Régimen inválido: 3.3 % de anómalos, pero de fase
    (el INT se adelanta ~9.5 ms sin blanco y regresa al entrar uno), no
    ranuras perdidas. analizar_cielo.py verifica el fondo con las válidas
    de más de 1 s después de apagarse el LED (1/2473). Se conserva el
    intento 2, cortado a mano, sin muestras.
2026-10-25 Mueve el Maestro v2.1 a history y deja S2 abierta hasta correr al cielo
    La v2.2 ya la declaraba superseded; el usuario autorizó moverla. La
    corrida larga del intento 3 se hizo con fondo de vidrio, así que S2
    queda abierta: S2b la repite apuntando al cielo abierto con el mismo
    sketch. Los cambios al Maestro esperan a S2b.
2026-10-25 webapp: contrato hub-página (PROTOCOLO.md, versión 1)
    Antes de escribir la página se fija el formato que comparten el hub, la
    página y la futura nube: mensajes WebSocket (estado, corrida, armar,
    desarmar, hora), endpoints de roster, configuración y sesión, y el CSV.
    Tiempos en ms enteros por la red y centésimas en pantalla; una puerta
    sin detección es null, nunca se interpola; cada corrida guarda las
    distancias vigentes (REQ-F-06).
2026-10-25 webapp: pantalla En vivo y hub simulado
    index.html con la franja de cancha (cada puerta en su distancia real, el
    split encima de su línea de yarda), el tiempo final en grande, armar y
    desarmar, puertas sin señal y banda de conexión caída con reconexión
    cada 1 s. sim.js implementa PROTOCOLO.md en el navegador y solo se
    carga con ?sim=1; no se embebe. Con el simulador, de que llega la
    corrida a que se dibuja pasan 3-8 ms (REQ-F-05 pide <= 2 s).
2026-10-25 webapp: pantallas Sesión, Atletas y Ajustes con CSV
    Sesión: corridas por llegada o más rápidas, filtro por atleta y mejor
    40 marcado; una corrida medida con otra distancia la muestra junto al
    tiempo (REQ-F-06). Atletas: alta, edición y baja contra /api/roster,
    dorsal único y borrado con doble confirmación que avisa cuántas
    corridas quedan sin nombre. Ajustes: distancias enteras y crecientes, y
    CSV armado en el teléfono con el formato de PROTOCOLO.md. Rojo solo
    para errores. 26.9 KB, 8.7 KB con gzip.
2026-10-25 webapp: prueba automática con el simulador, README y cierre de W1
    probar.py recorre el flujo completo en Chromium a 390 px (armar,
    corrida, puerta sin señal, conexión caída, sesión, roster, distancias,
    CSV) con 23 comprobaciones y deja capturas en webapp/capturas/, que
    git ignora. El README explica cómo abrir la página sin placas. ESTADO
    pasa W1 a hecho, agrega W2 (embeberla en el hub) y anota la idea de
    recomendaciones en la nube como fuera de alcance según el Maestro 4.1.
2026-10-25 webapp: controles con esquinas redondeadas
    Preferencia del usuario. Botones, campos y selectores con radio de 10 px
    (18 px el botón de armar); la franja de cancha y la tabla siguen rectas
    porque son líneas de yarda. probar.py: todo OK.
2026-10-25 hardware: guía del esquemático de la placa de nodo (PDF para KiCad)
    Bloque por bloque desde las secciones 11.2, 12 y 15.1 del Maestro, con
    la firmeza de cada decisión (Maestro, propuesta o pendiente): energía
    con protección y cargador, headers de la tarjeta ESP32, sensor con load
    switch, interfaz, test points, asignación de GPIO y roles por 2
    jumpers. Marca dos trampas de la placa portadora: la tierra del módulo
    cargador (OUT-, no B-) y el USB de la tarjeta compitiendo con el
    buck-boost en 3V3. Incluye el procedimiento para medir el riel de 3.3 V
    con osciloscopio bajo la carga de S3. ESTADO agrega H1 y E1.
2026-10-25 ADR-013: módulo ESP32 soldado y PCB ensamblada; guía del esquemático v2
    Decisión del usuario: el WROOM-32UE va soldado y el fabricante ensambla
    la placa, en lugar de la tarjeta en headers del Maestro 12.1. Cargador y
    buck-boost pasan de módulos genéricos a sus integrados (TP4056 + DW01A
    + FS8205A, TPS63021) y un solo USB-C carga y programa con CH340C y
    auto-reset. Así los 5 V del USB solo van al cargador y desaparece la
    trampa de dos fuentes en 3V3. La guía agrega el bloque USB/carga, el
    arranque del módulo, campos LCSC y puentes de 0 ohm para energizar por
    bloques. ADR-012 queda reservado para el reintento de ráfagas.
2026-10-25 Cierre de sesión: reporte de la corrida larga, ESTADO para retomar y CLAUDE.md
    El reporte del sensor agrega la sección 11: corrida larga a IMP 25 con
    fondo de vidrio (0 saltos con blanco, 3.3 % de anómalos de fase sin
    blanco), los tres intentos y sus incidencias. ESTADO abre con "Cómo
    retomar" (qué está hecho, qué hace el usuario, orden de S2b, E1 y
    Exp. 1, cómo correr lo existente), agrega H2 (cotización JLCPCB),
    corrige las secciones de la guía y quita decisiones ya resueltas.
    CLAUDE.md refleja webapp/, hardware/, docs/adr/, ADR-013 y Playwright.
2026-10-26 ESTADO: S2b sin predicción, registrado antes de correr
2026-10-26 S2b: corrida larga al cielo abierto a IMP 25; S2 cerrada
    ADR-011 se sostiene: 0 saltos a 2 ranuras en 1022 intervalos con blanco,
    3.0 % de anómalos sin blanco (vidrio 3.3 %) y fondo limpio (0/2471).
    Hallazgo con fase_cruces.py: sin blanco el INT va ~9.9 ms adelantado y en
    cada cruce la detección cae en la fase con blanco (29/29); los anómalos son
    una sola interrupción tardía (par + -), lo que corrige la lectura de la 11.4.
2026-10-26 Documento Maestro v2.3: corridas largas del sensor y ADR-013
    9.2: las corridas a IMP 25 en régimen sin retorno (vidrio y cielo) cierran la
    nota provisional; se agrega el hallazgo de las dos fases del INT y su posible
    efecto en el presupuesto (hasta 9.6 ms por sensor, sin medir). 16.3: el Exp. 1
    debe registrar el intervalo previo a cada detección; la predicción no cambia.
    12, 15, 17, 18 y 19: ADR-013 (módulo soldado, placa ensamblada). La 0.4 lista
    los cambios. La v2.2 se conserva en docs/ hasta decidir moverla a history/.
